mehmetkl/AC-DC-Battery-Charger-Project/Final simulations + model/final plots/rectifier diode current.jpg

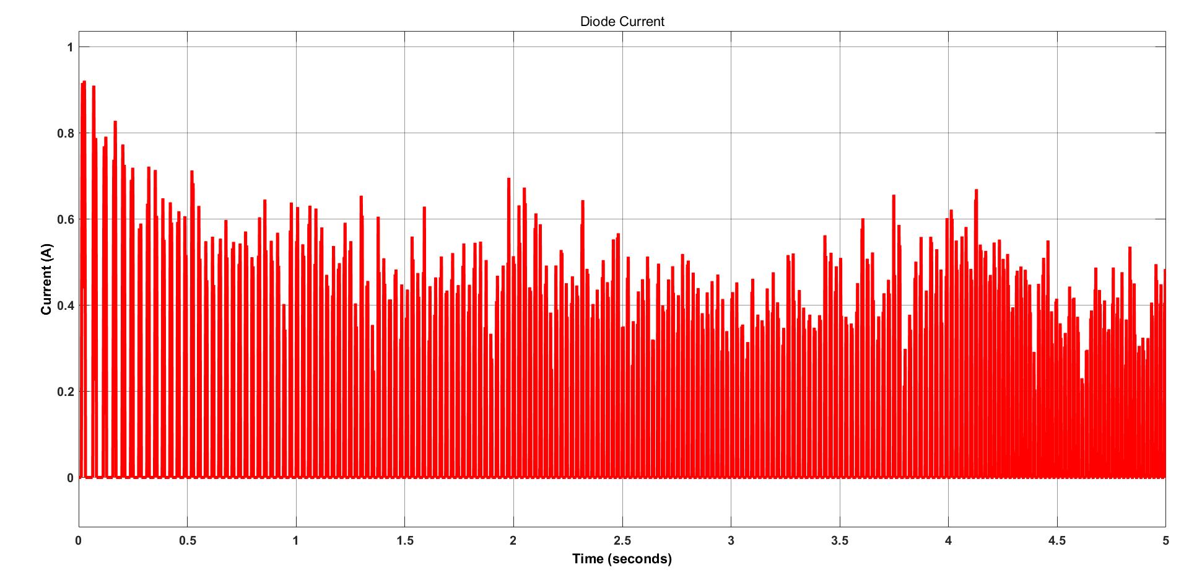
Final simulations + model/final plots/rectifier diode current.jpg
