mehmetkl/AC-DC-Battery-Charger-Project/README.md

# EE463-Term-Project
Aim of this project is development of an AC to DC battery charger. @alibelli and @mustafayildz are my partners.

Report Link;
https://docs.google.com/document/d/1pQeKIka4XDIwBPZ2k292Jc178dQlImezZrbRqhxObMo/edit
