mehmetkl/AC-DC-Battery-Charger-Project/Report/PCB.docx

Appendix

Printed Circuit Board Drawings

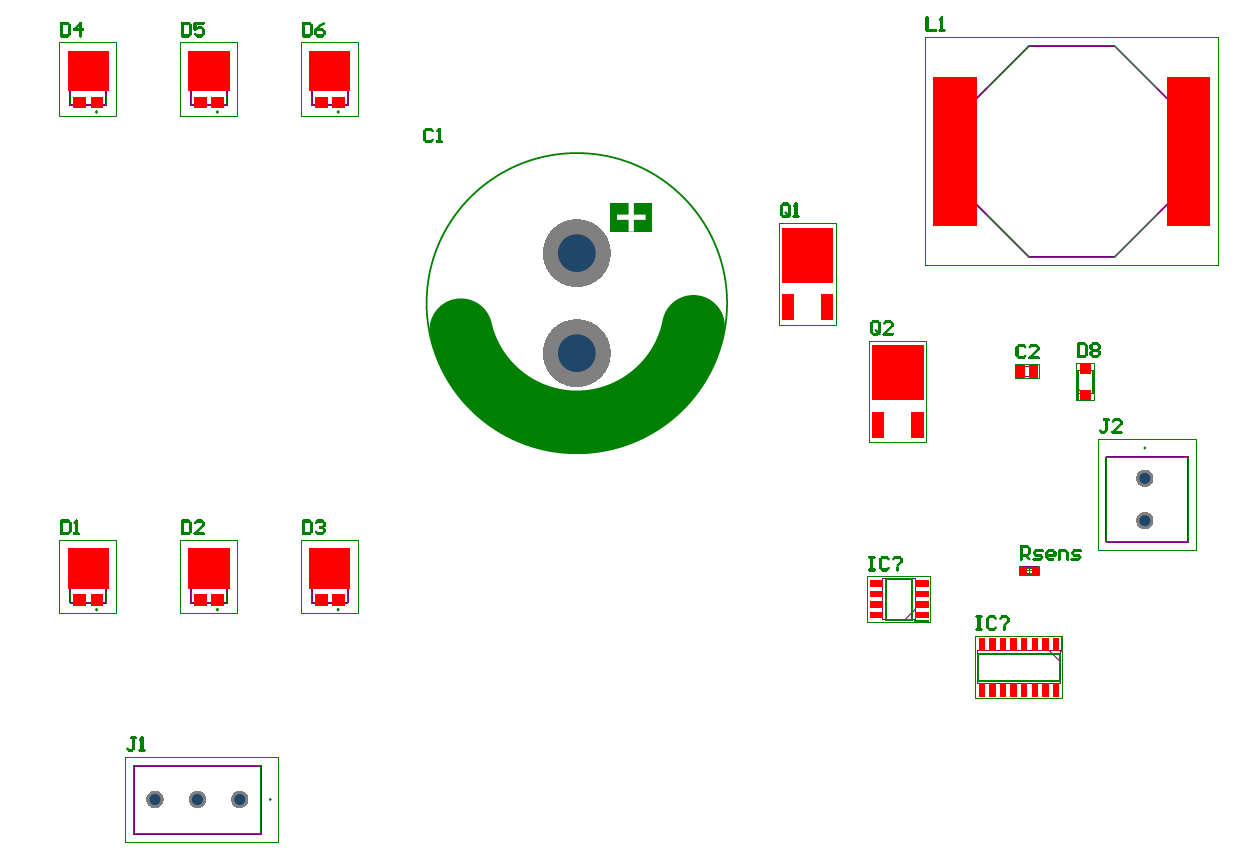
[picture p53: figure]

Figure 1. Approximate distribution of Components on PCB (The PCB limits are not shown for demonstration)

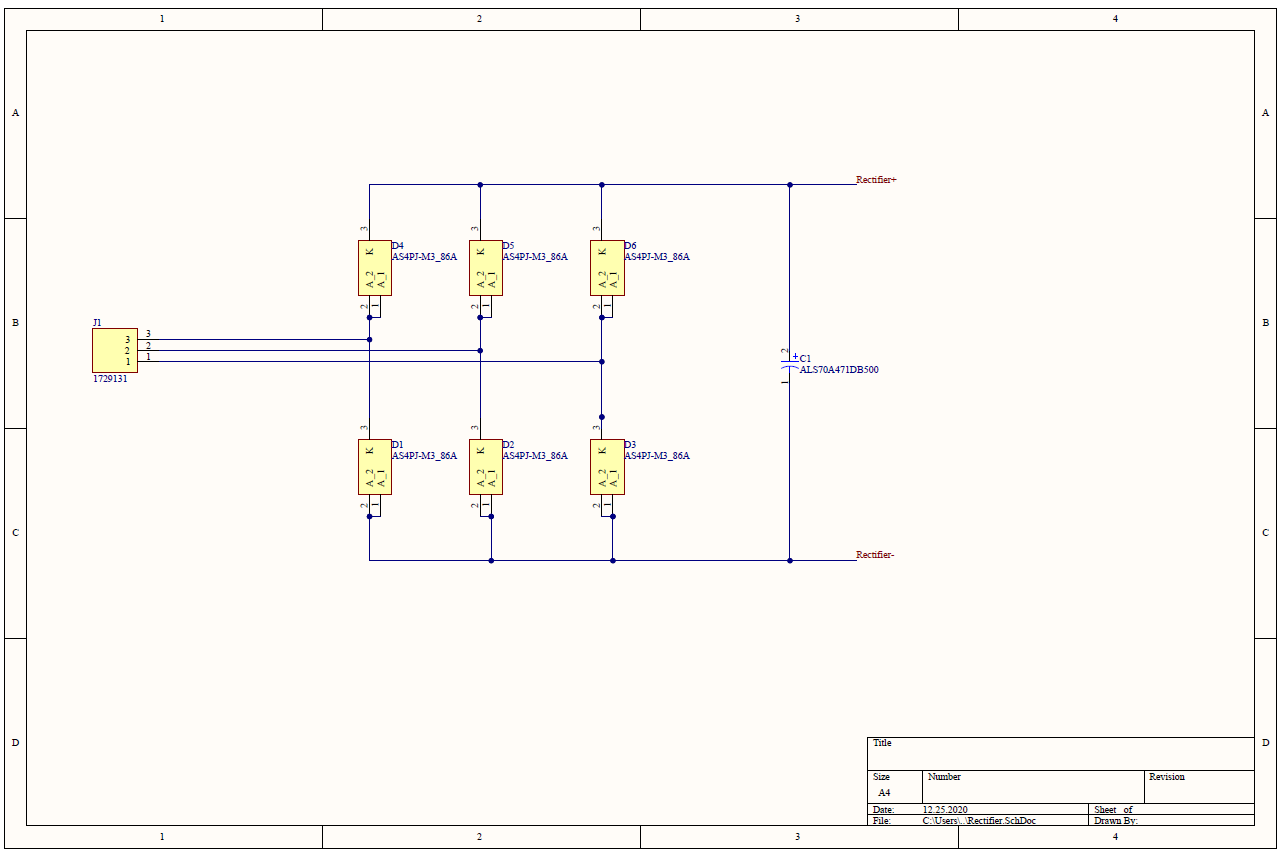
[picture p54: figure]

Figure 2. Completed Schematic of rectifier circuit

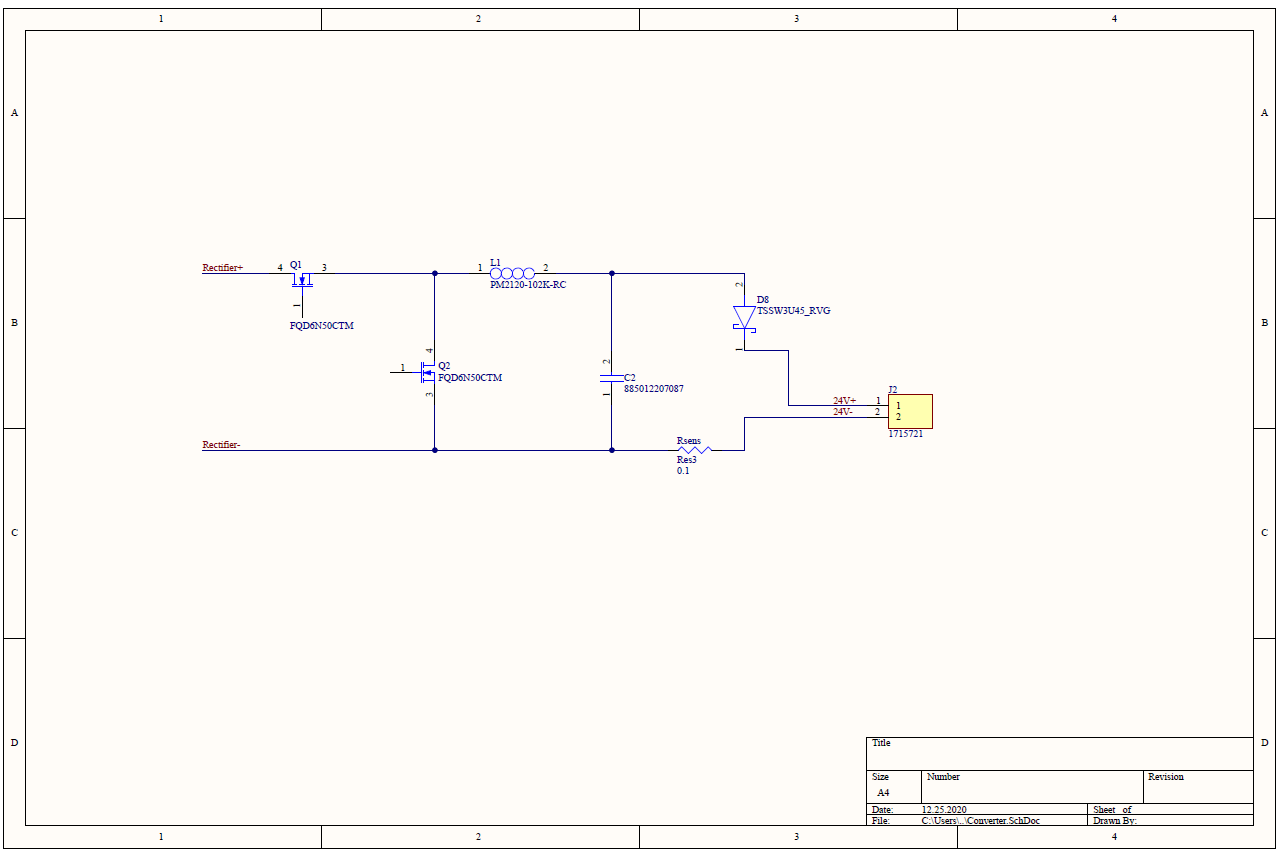
[picture p55: figure]

Figure 3. Schematic of Buck Converter circuit (Current sense is missing)

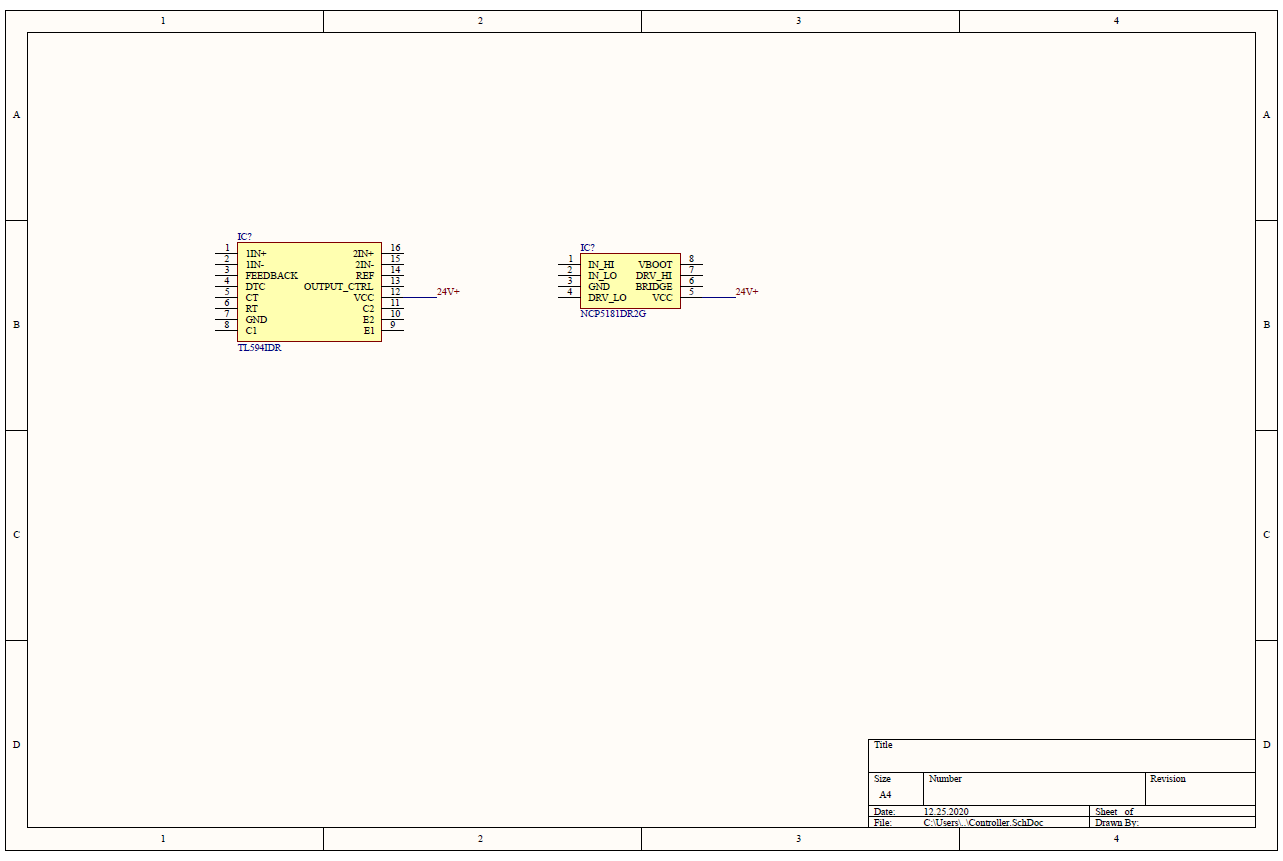
[picture p56: figure]

Figure 4. Schematic of Controller with only Integrated Circuits
