mehmetkl/AC-DC-Battery-Charger-Project/TermProjectPresentation.pptx

## METU Electrical&Electronics Engineering EE463 – Term Project Deadly Viper Assassination Squad Inc.

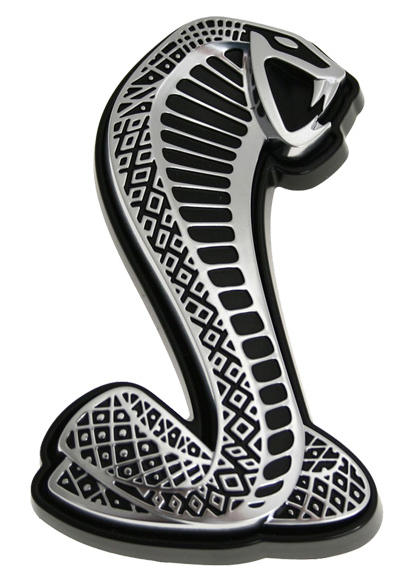
[picture p57: figure]

Mustafa Yıldız
Ali Belli
Mehmet Kılıç

## Problem Definition

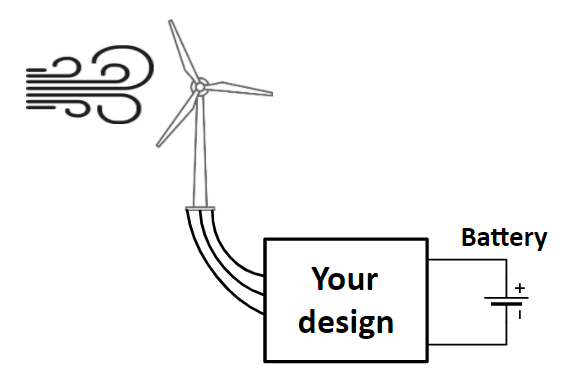
[picture p58: figure]

- Variable amplitude
- Variable frequency
- Regulated output

## Topology Discussion

- Thyristor Rectifier

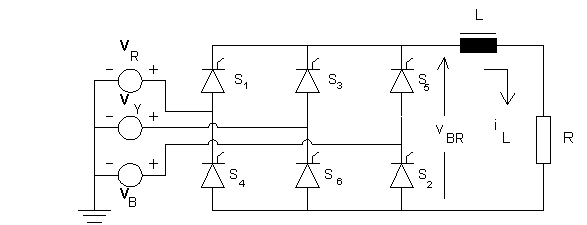
[picture p59: figure]

## Topology Discussion

- Full Wave Diode rectifier and Two Stage Buck Converter

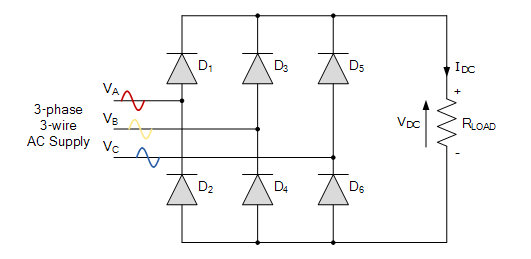
[picture p60: figure]
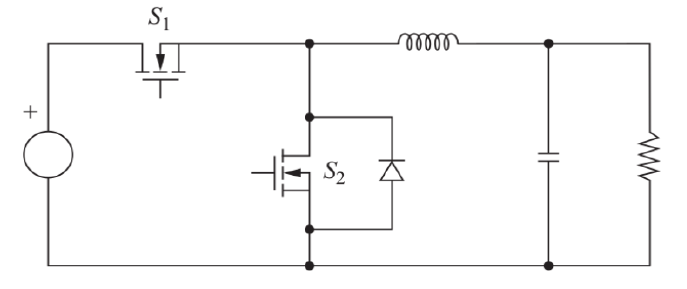
[picture p61: figure]

## Topology Discussion

- Full Wave Diode rectifier and Buck Converter

## Topology Discussion

- Half Wave Diode Rectifier and Full Wave Diode Rectifier

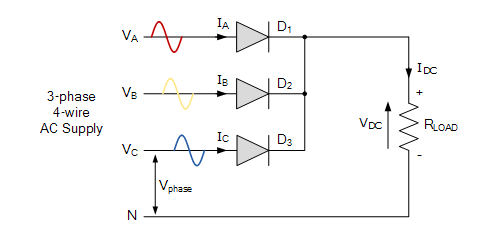
[picture p62: figure]

## General View of the System

## Input and Rectifier Stage

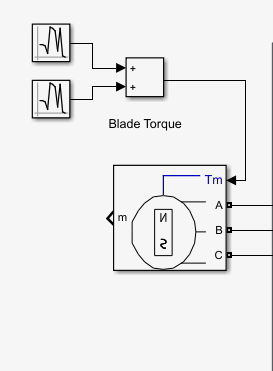
[picture p63: figure]
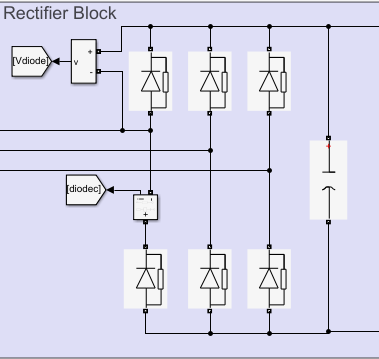
[picture p64: figure]

## Input and Rectifier Stage

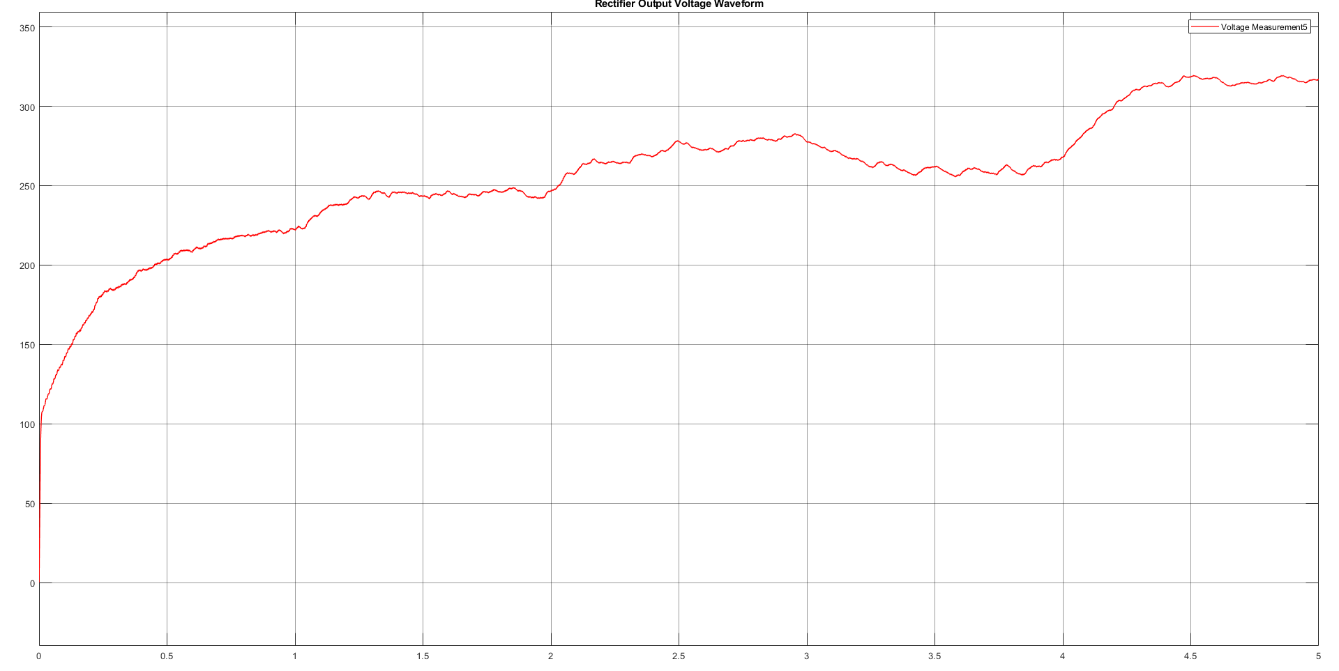
[picture p65: figure]

## Rectifier Stage Output Waveforms

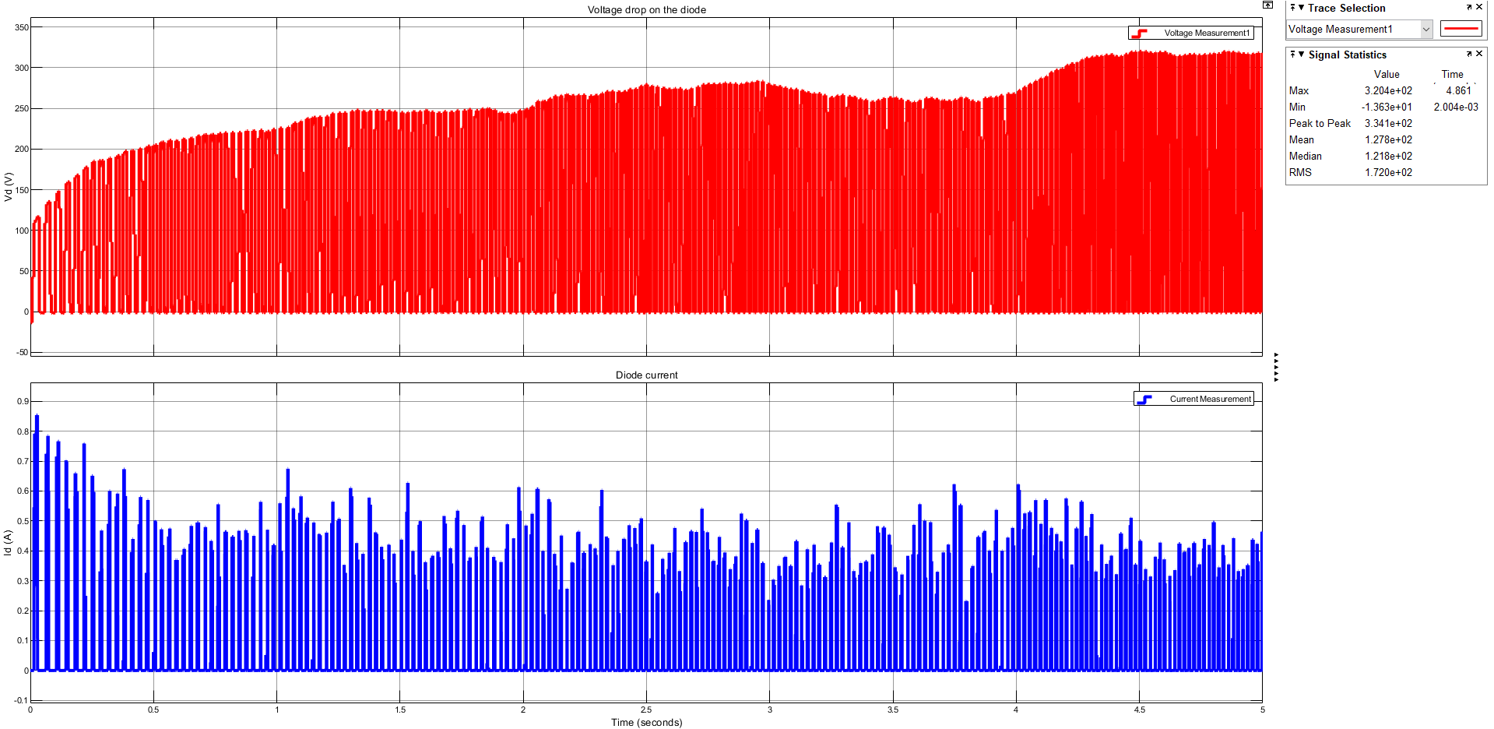
[picture p66: figure]

## Rectifier Stage Component Selection

AS4PJ-M3/86A Diode ALS70A471DB500 Electrolytic Capacitor

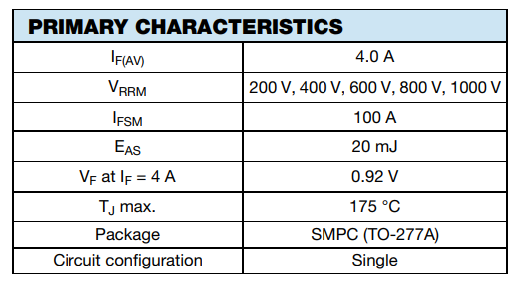
[picture p67: figure]
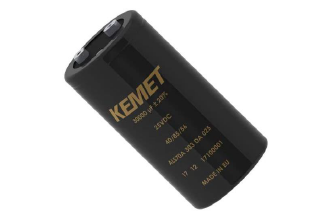
[picture p68: figure]

## Buck Converter and Synchronous Buck Converter


## Synchronous Buck Converter Stage

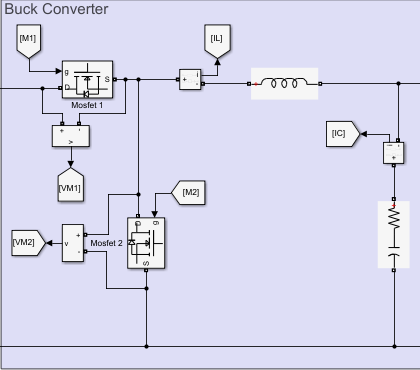
[picture p69: figure]

## Buck Converter Simulation Results

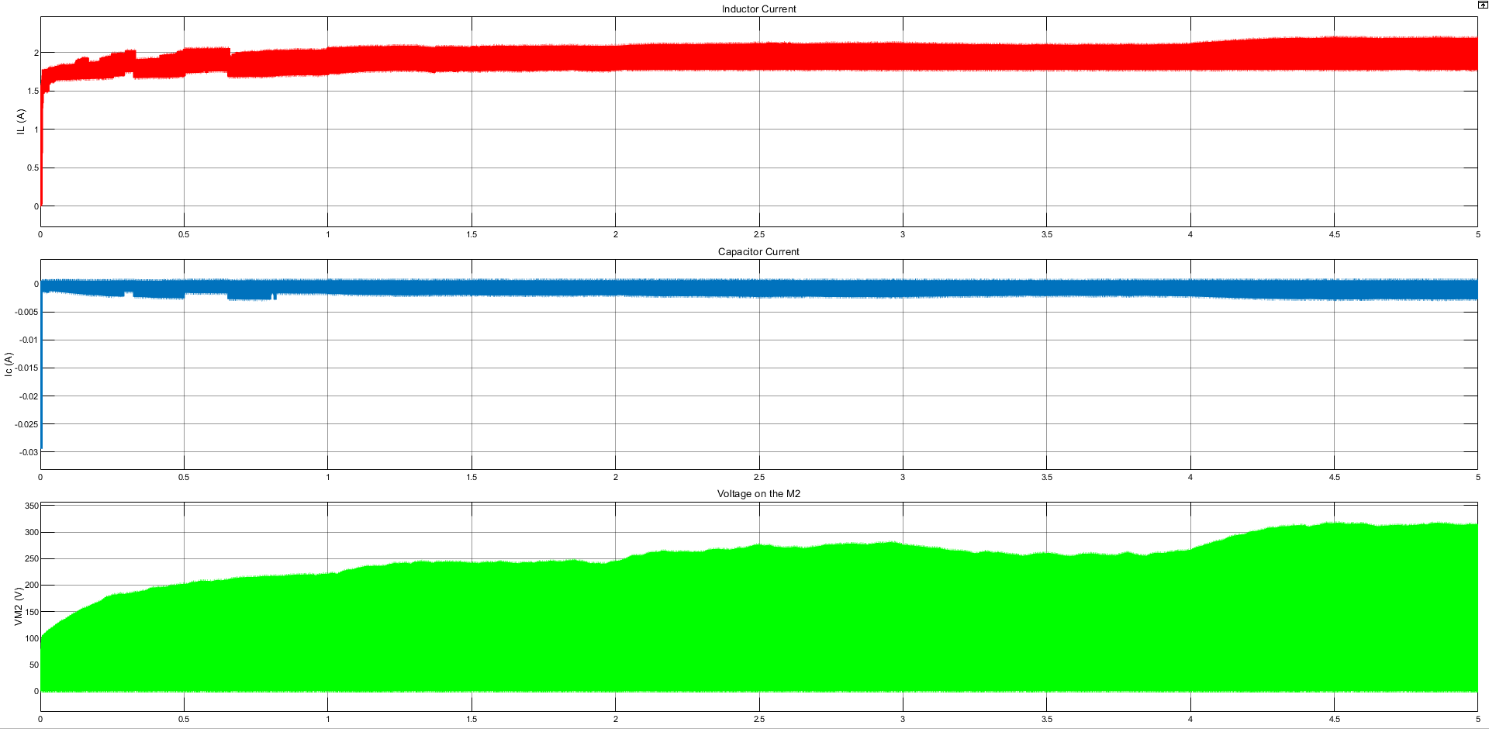
[picture p70: figure]

## Buck Converter Simulation Results

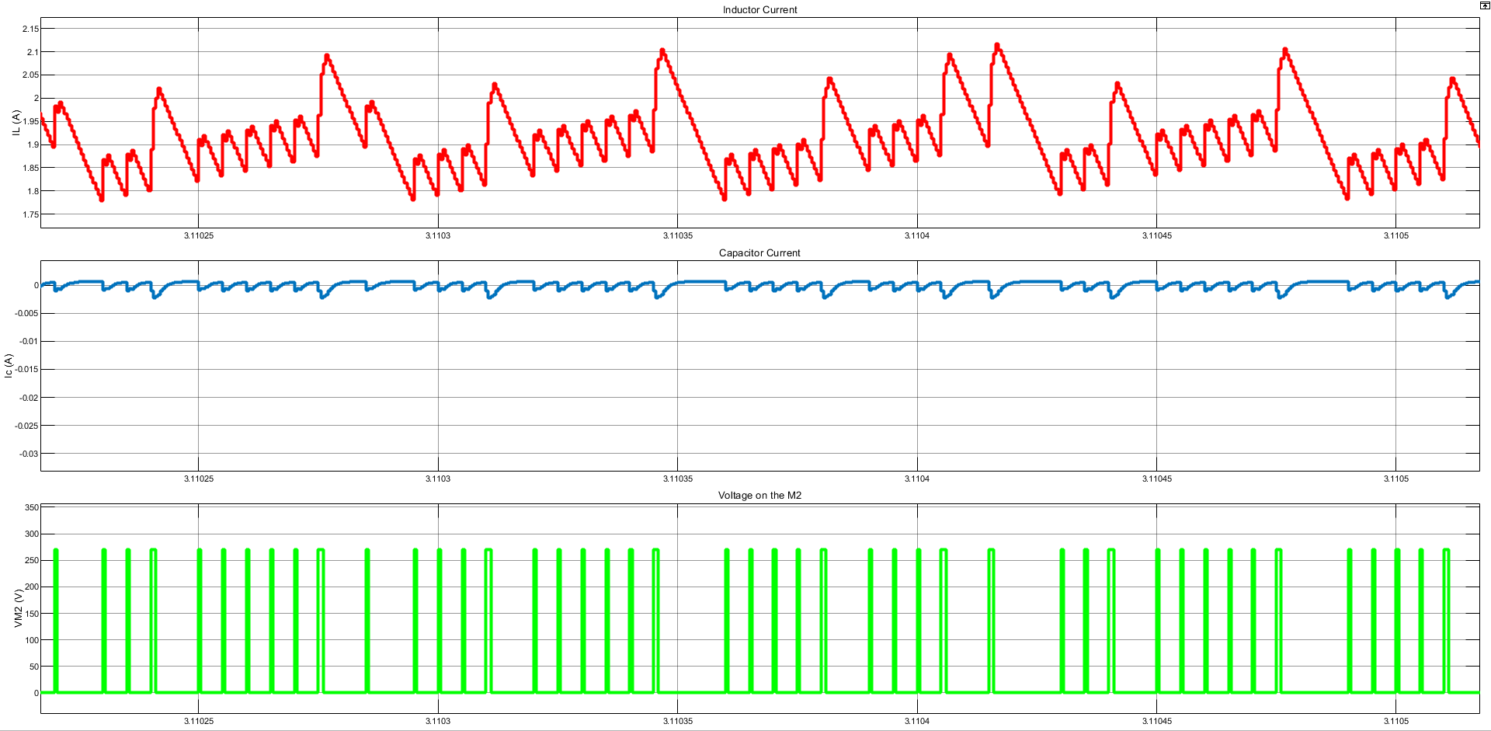
[picture p71: figure]

## Buck Converter Simulation Results

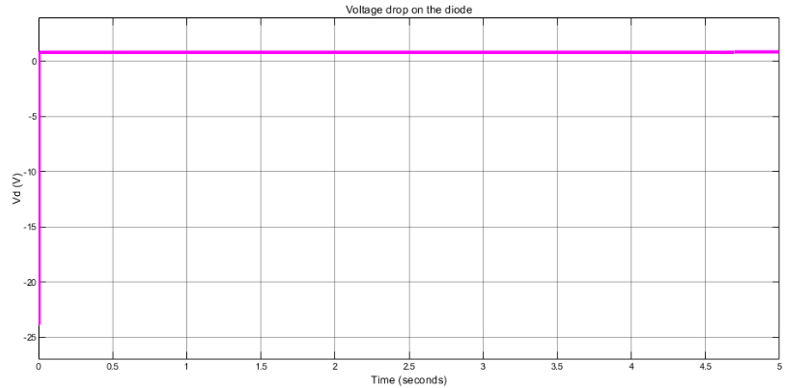
[picture p72: figure]

TSSW3U45 45V/3A

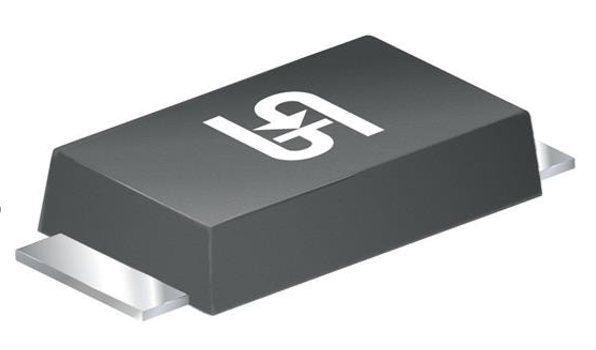
[picture p73: figure]

## Buck Converter Simulation Results

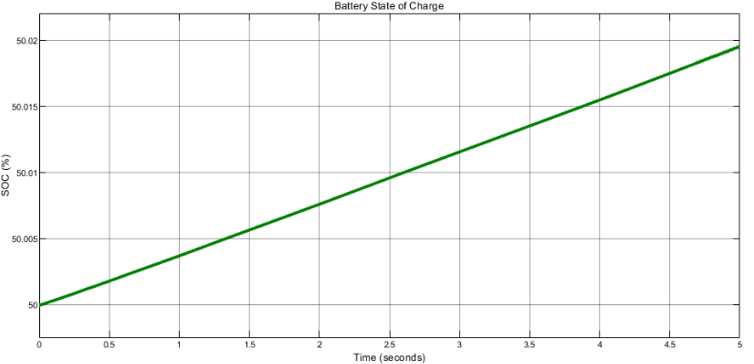
[picture p74: figure]

## Buck Converter Component Selection

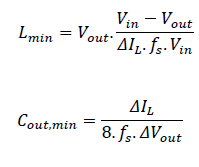
[picture p75: figure]

## Buck Converter Component Selection

PM2120-102K-RC 1mH Inductance 885012207087 1500nF Capacitor FQD6N50C-D 500V/4.5A

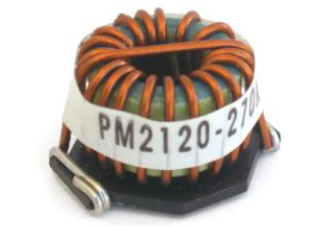
[picture p76: figure]
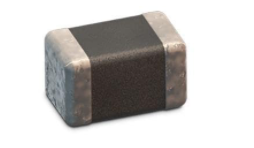
[picture p77: figure]
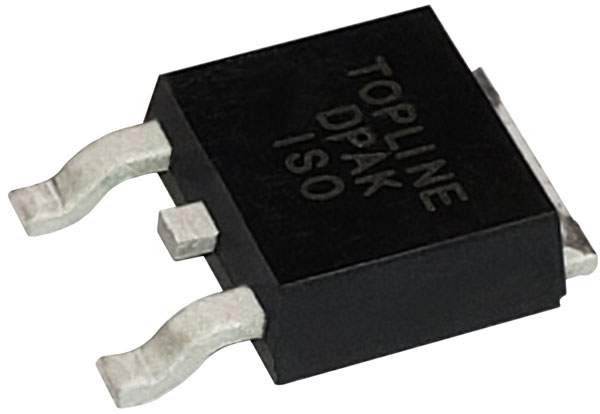
[picture p78: figure]
DPAK, D2PAK package JEDEC device TopLine Dummy Component Power Transistor DPAK, DPAK-E13A, DPAKE13A, DPAK E13A, DPAK-E7A, DPAKE7A, DPAK E7A, DPAK3, DPAK-2, DPAK 2, DPAK2, DPAK-3, DPAK 3, DPAK3, D-PAK, DPACK, D-PACK, DPAK (

## Controller Stage

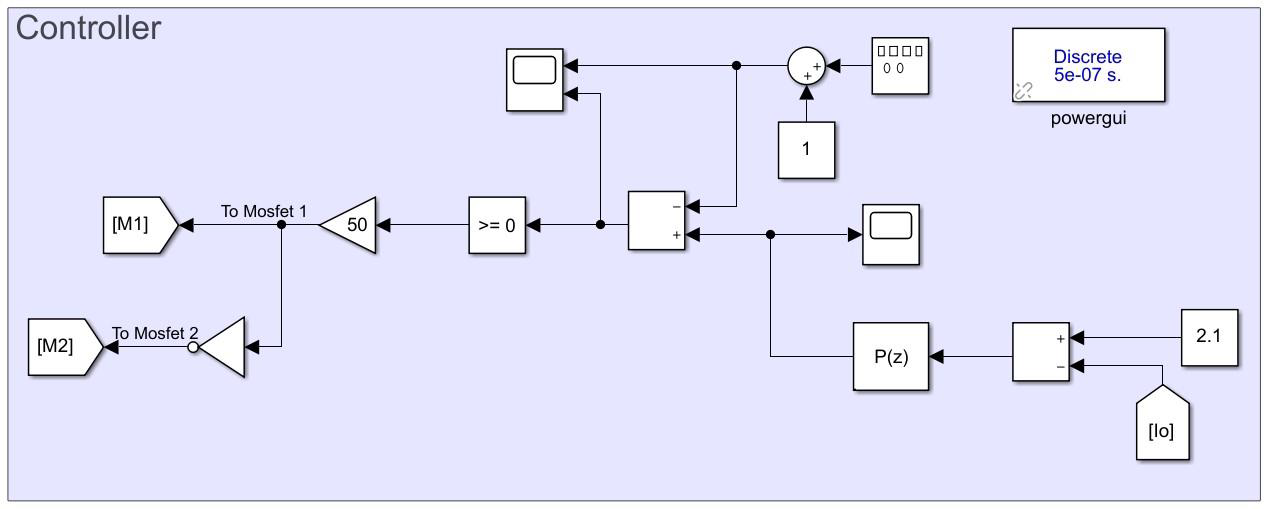
[picture p79: figure]

## Controller Stage Waveforms

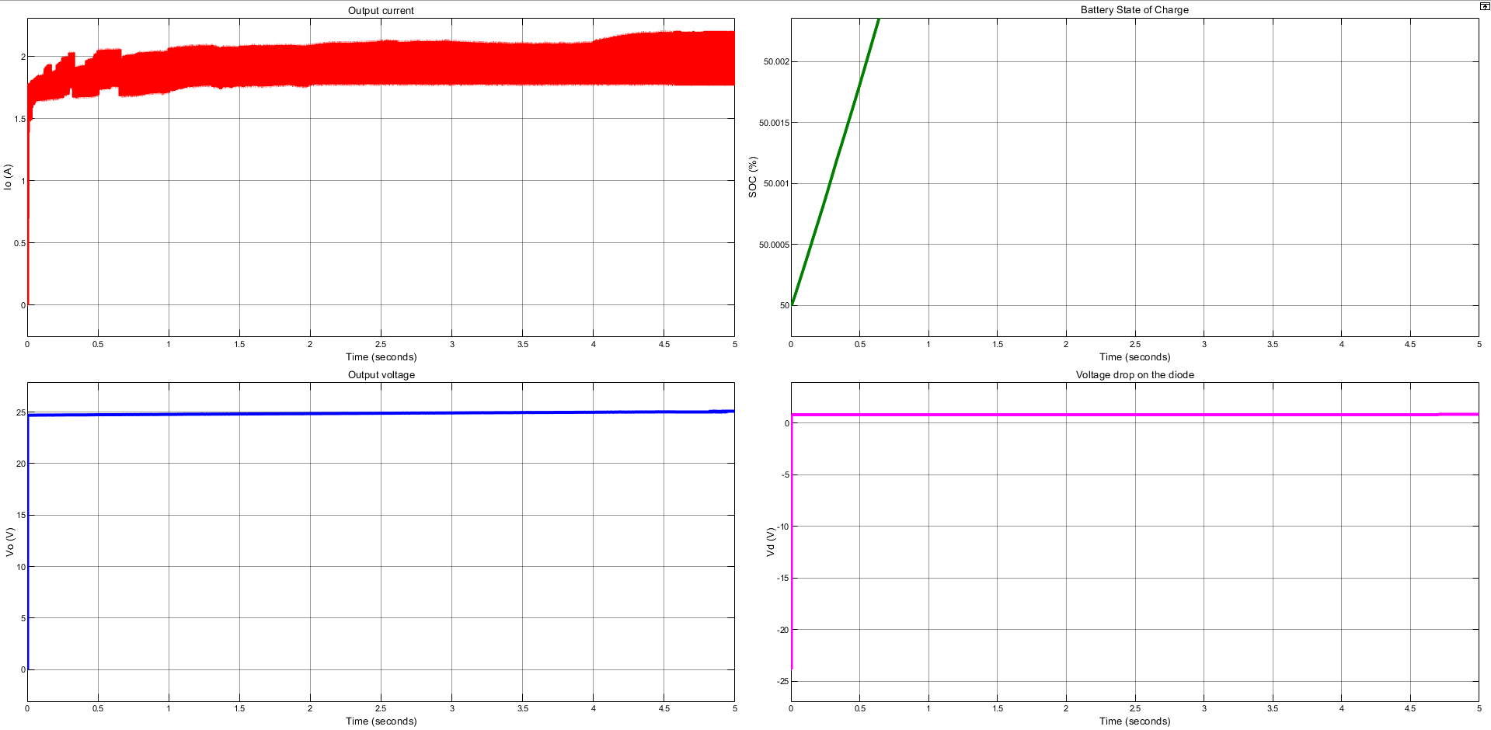
[picture p80: figure]

## Controller Stage Output Current Waveform

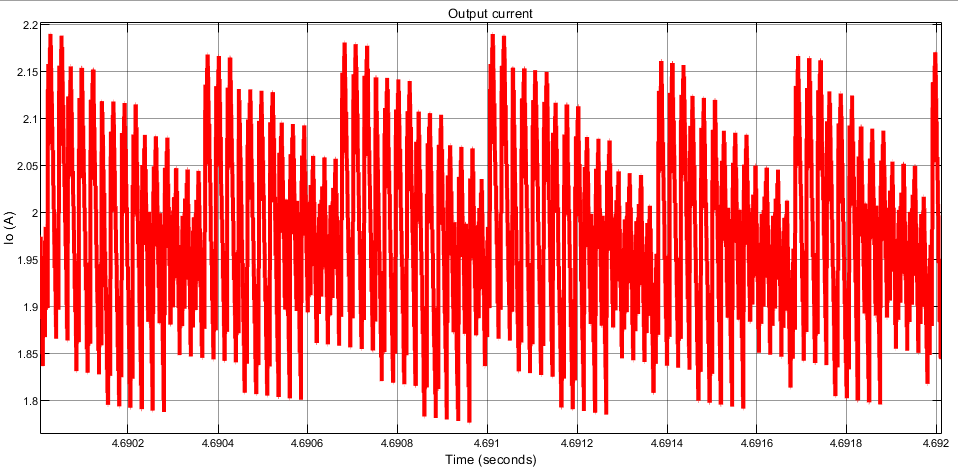
[picture p81: figure]

## Controller Stage Component Selection

PWM Generator TL594IDR Dual Output Mosfet Driver NCP5181DR2G, up to 600V

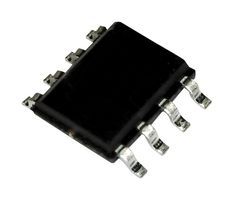
[picture p82: figure]
NCP5181DR2G - ON SEMICONDUCTOR - MOSFET/IGBT Driver, Half Bridge, 10V to 20V Supply
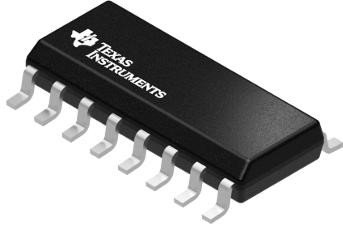
[picture p83: figure]
TL594IDR by Texas Instruments | Current Mode PWM Controllers | Arrow.com

## PCB Schematics

Rectifier Stage

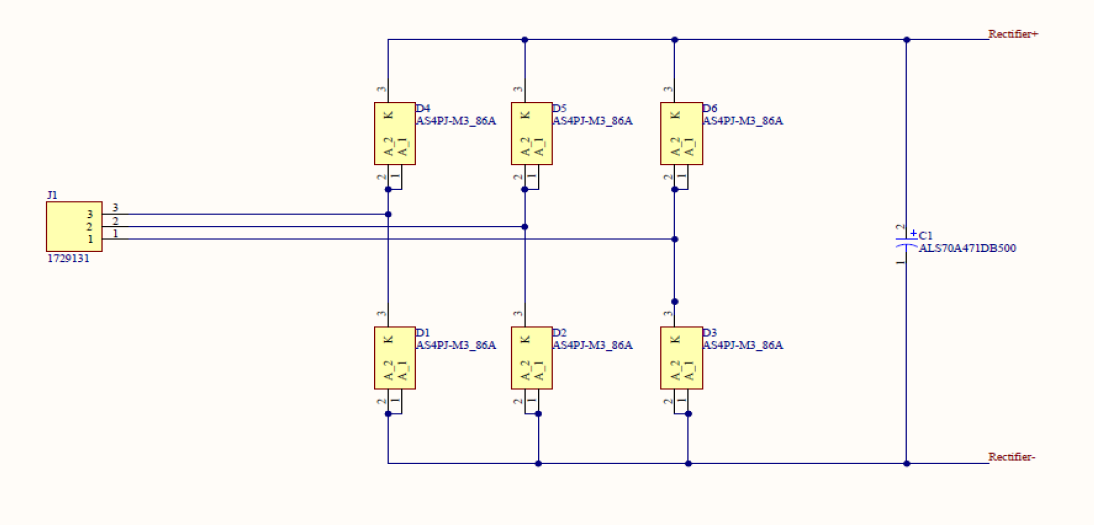
[picture p84: figure]

## PCB Schematics

Converter Stage

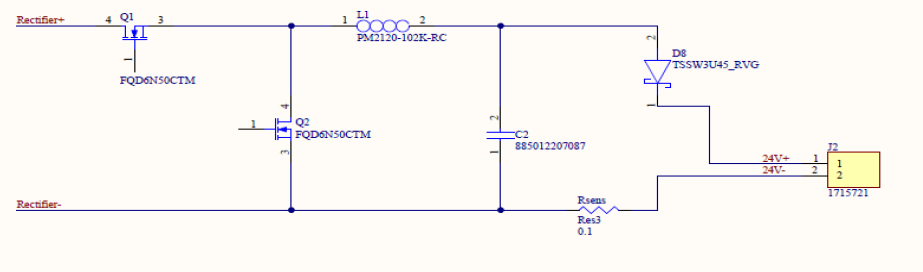
[picture p85: figure]

## PCB Schematics

PCB Layout without Wirings and Mechanical Limits of PCB

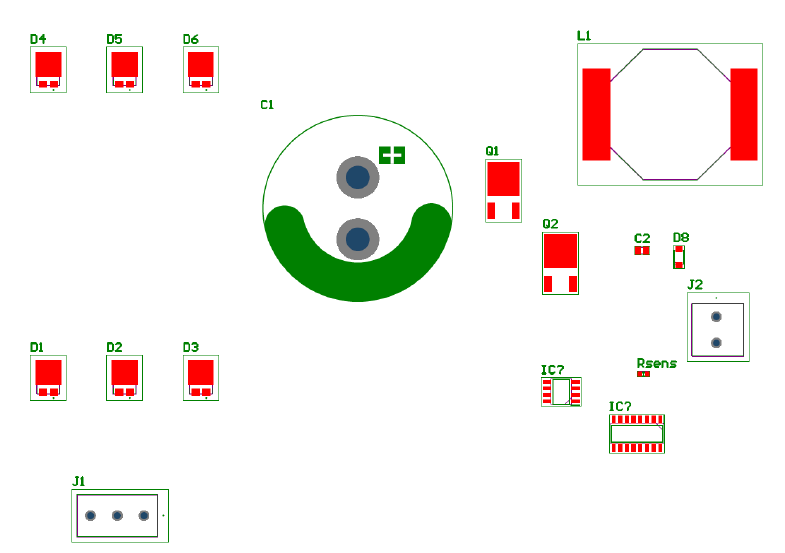
[picture p86: figure]

## Slide 27

Thanks for listening...
