mehmetkl/AC-DC-Battery-Charger-Project/Buck_converter/Buck converter parameters.docx

L_(min) =V_(out) .(V_(in) -V_(out))/(ΔI_L .f_s .V_(in))

L_(min) =(24x(300-24))/(0.4x200000x300)=2.74x10^(-4) H

C_(out,min) =ΔI_L /(8.f_s .ΔV_(out) )

C_(out) =0.4/(8x200000x0.5)=0.5x10^(-6) F
