mehmetkl/AC-DC-Battery-Charger-Project/Final simulations + model/controller block_new.jpg

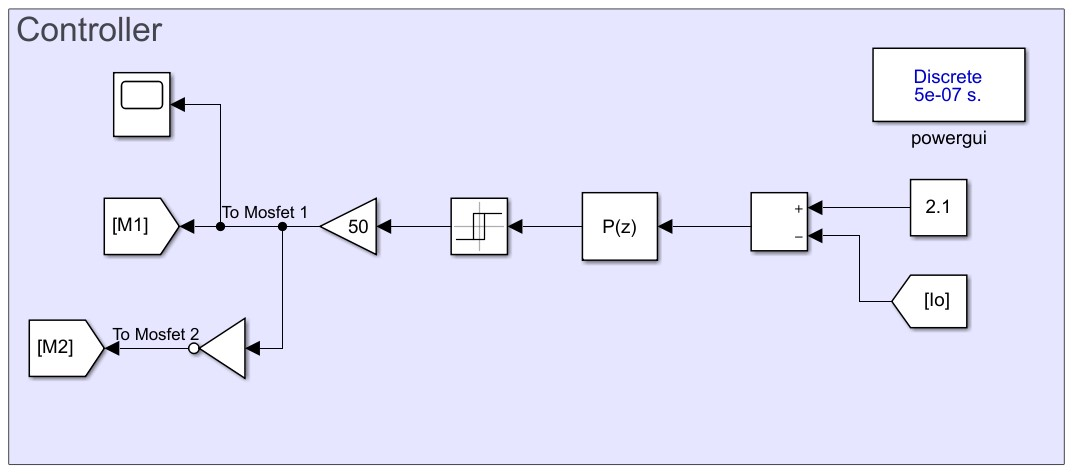
Final simulations + model/controller block_new.jpg
