mehmetkl/AC-DC-Battery-Charger-Project/Final simulations + model/final plots/inductor current.jpg

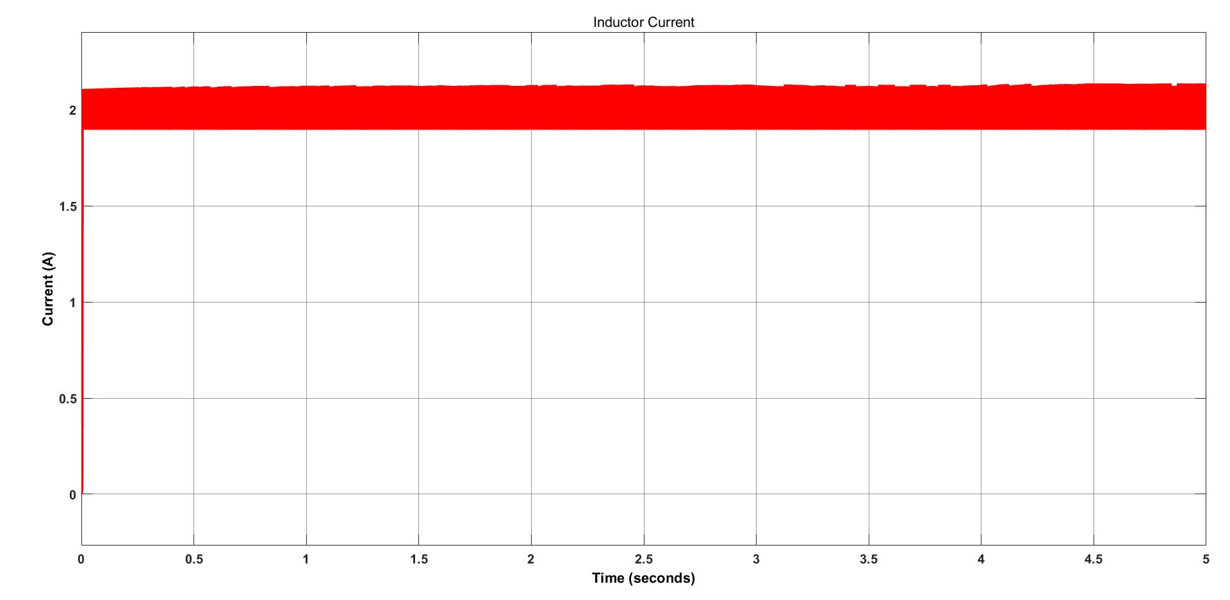
Final simulations + model/final plots/inductor current.jpg
