mehmetkl/AC-DC-Battery-Charger-Project/Final simulations + model/final plots/MOSFET 2 Voltage.jpg

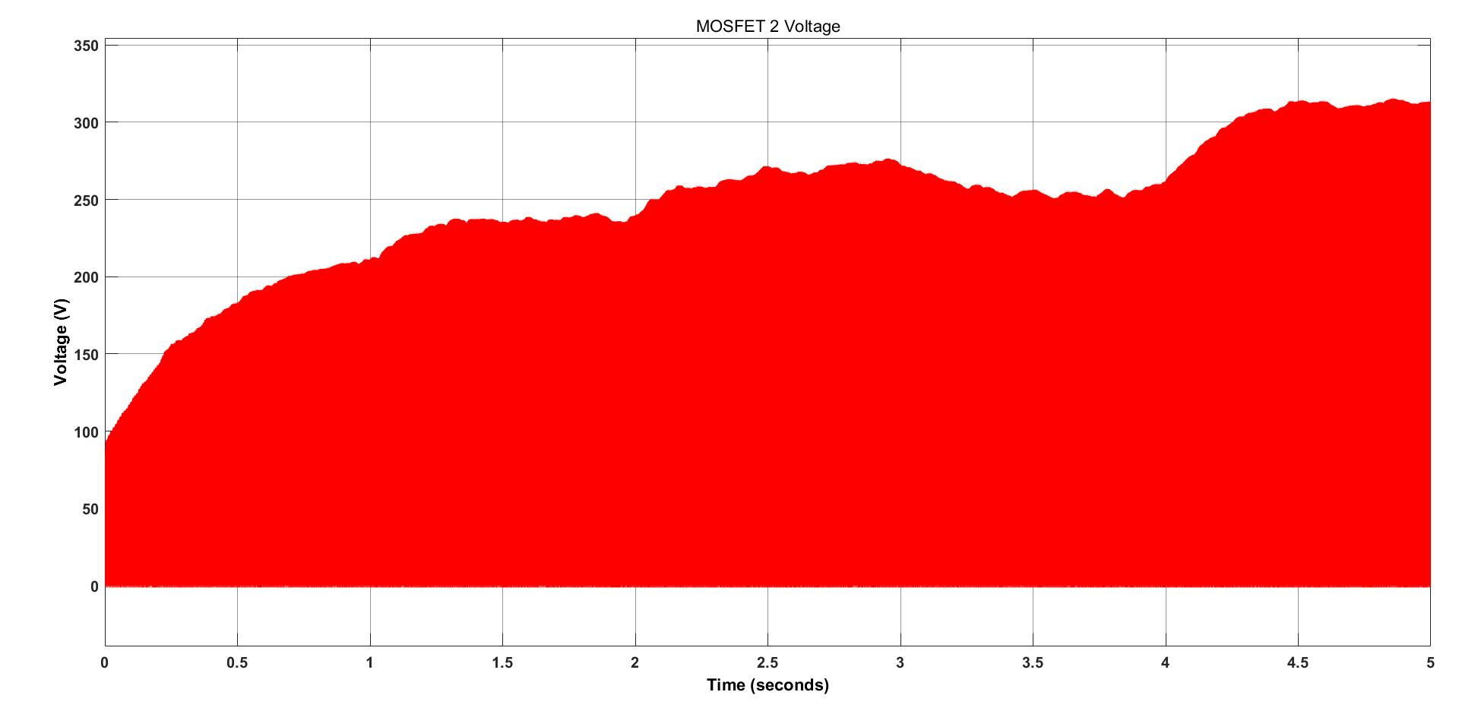
Final simulations + model/final plots/MOSFET 2 Voltage.jpg
