mehmetkl/AC-DC-Battery-Charger-Project/Final simulations + model/final plots/out cap current.jpg

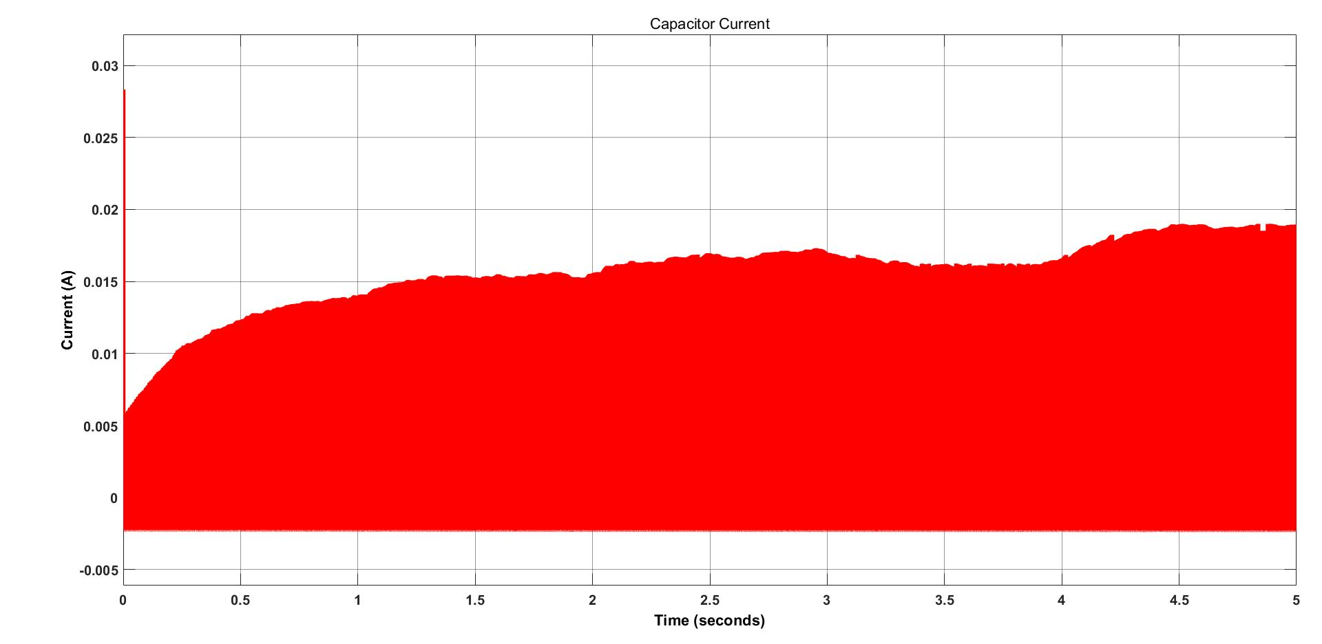
Final simulations + model/final plots/out cap current.jpg
