mehmetkl/AC-DC-Battery-Charger-Project/Final simulations + model/final plots/output voltage.jpg

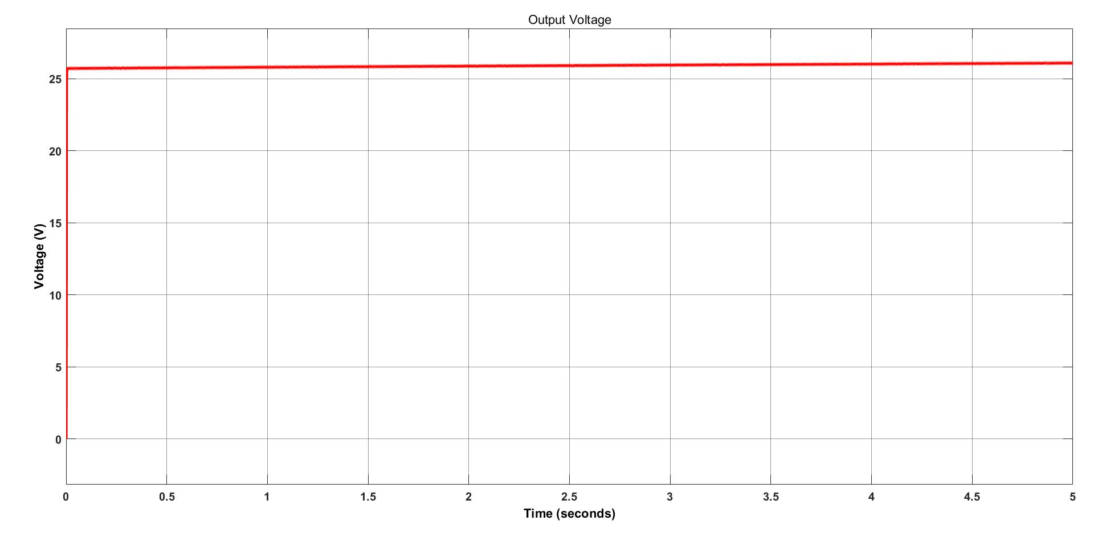
Final simulations + model/final plots/output voltage.jpg
