mehmetkl/AC-DC-Battery-Charger-Project/Final simulations + model/final plots/rectifier capacitor voltage.jpg

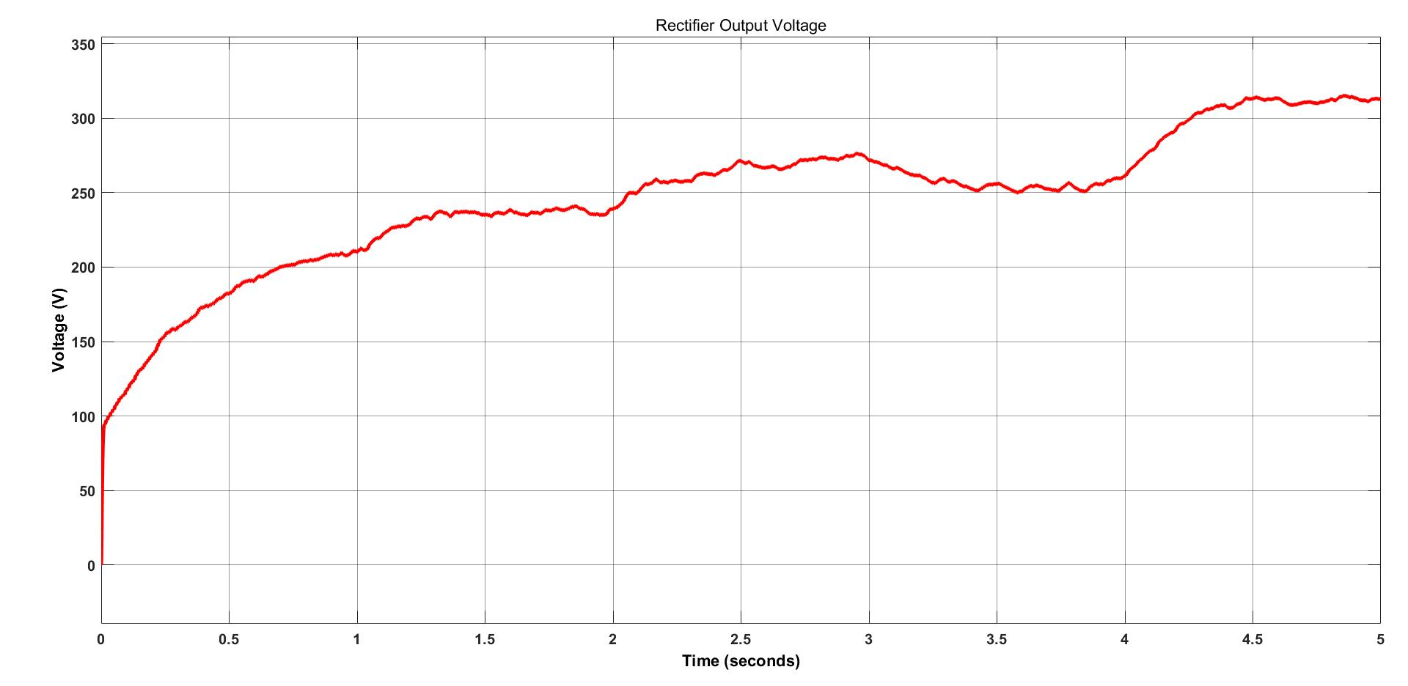
Final simulations + model/final plots/rectifier capacitor voltage.jpg
