mehmetkl/AC-DC-Battery-Charger-Project/Final simulations + model/final plots/SOC battery.jpg

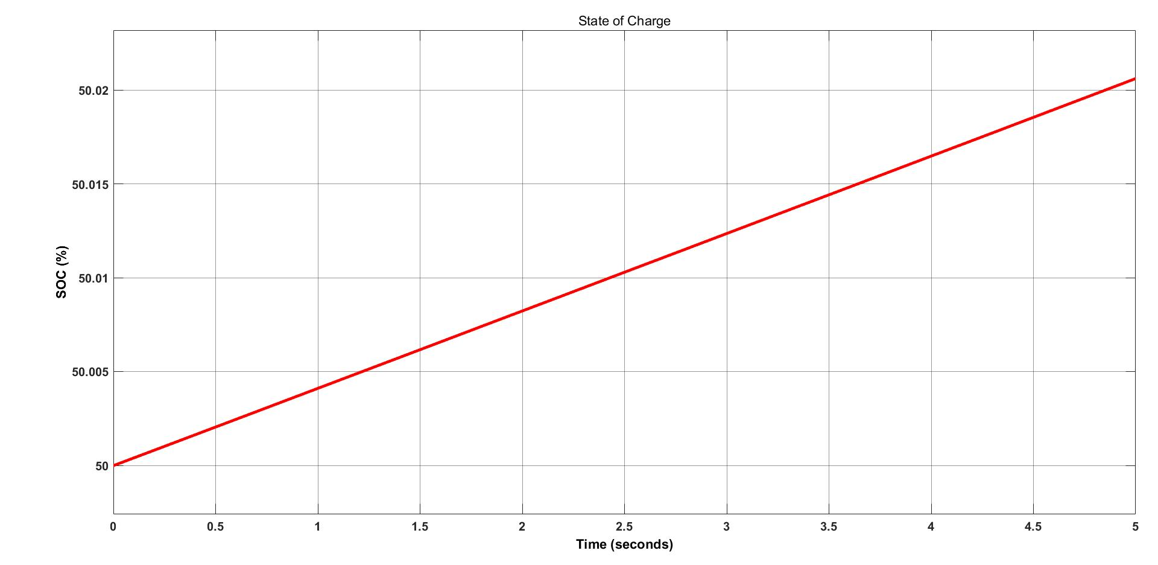
Final simulations + model/final plots/SOC battery.jpg
