mehmetkl/AC-DC-Battery-Charger-Project/Final simulations + model/rectifier block.jpg

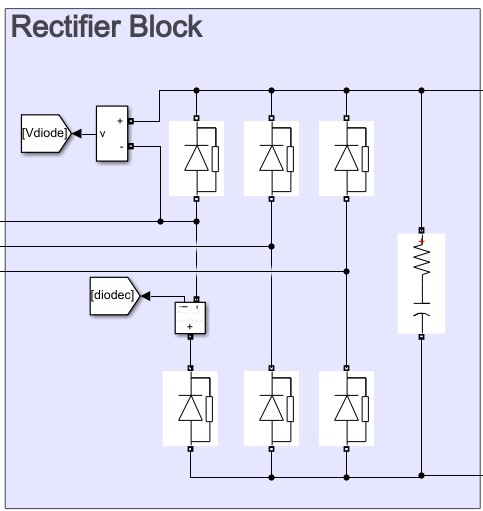
Final simulations + model/rectifier block.jpg
