mehmetkl/AC-DC-Battery-Charger-Project/Final simulations + model/Vm1 mosfet Voltage.png

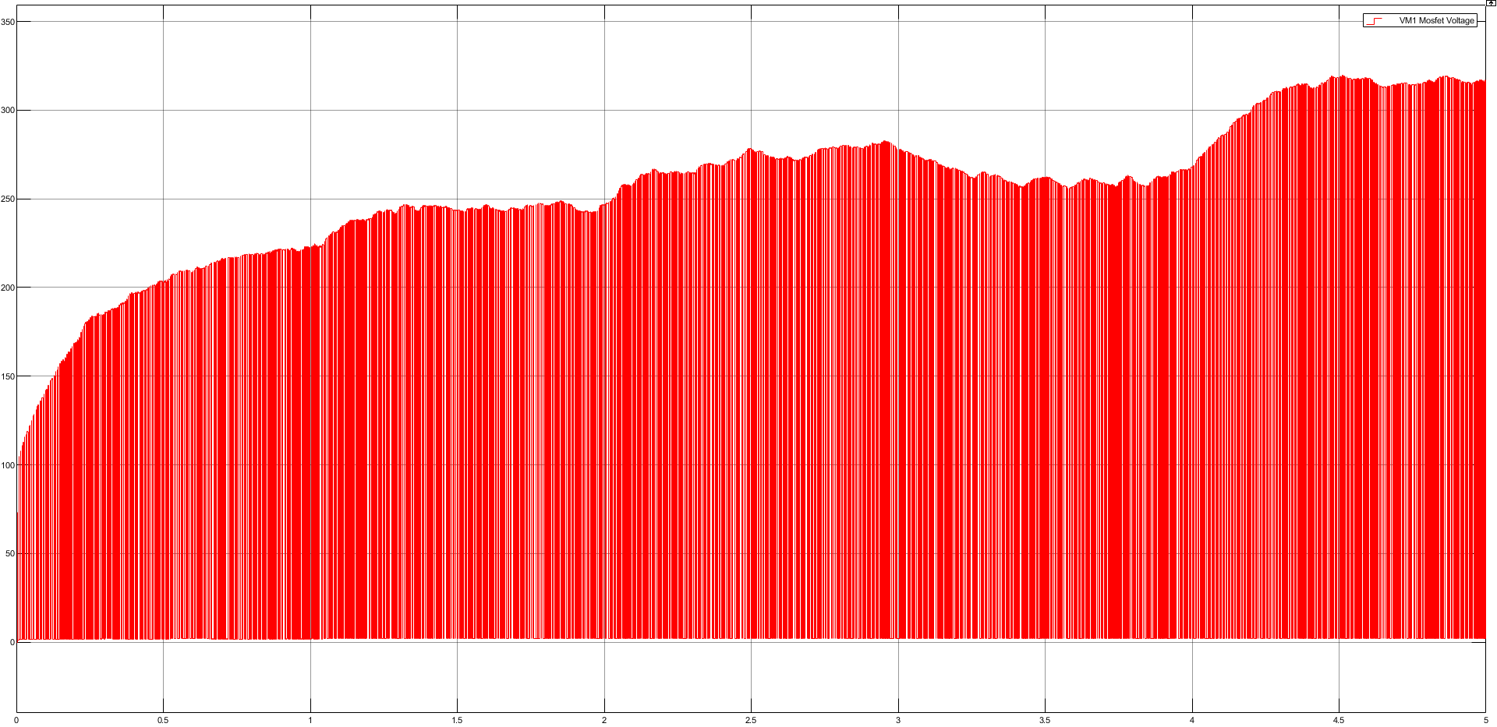
Final simulations + model/Vm1 mosfet Voltage.png
