mehmetkl/AC-DC-Battery-Charger-Project/Output Current Waveform.png

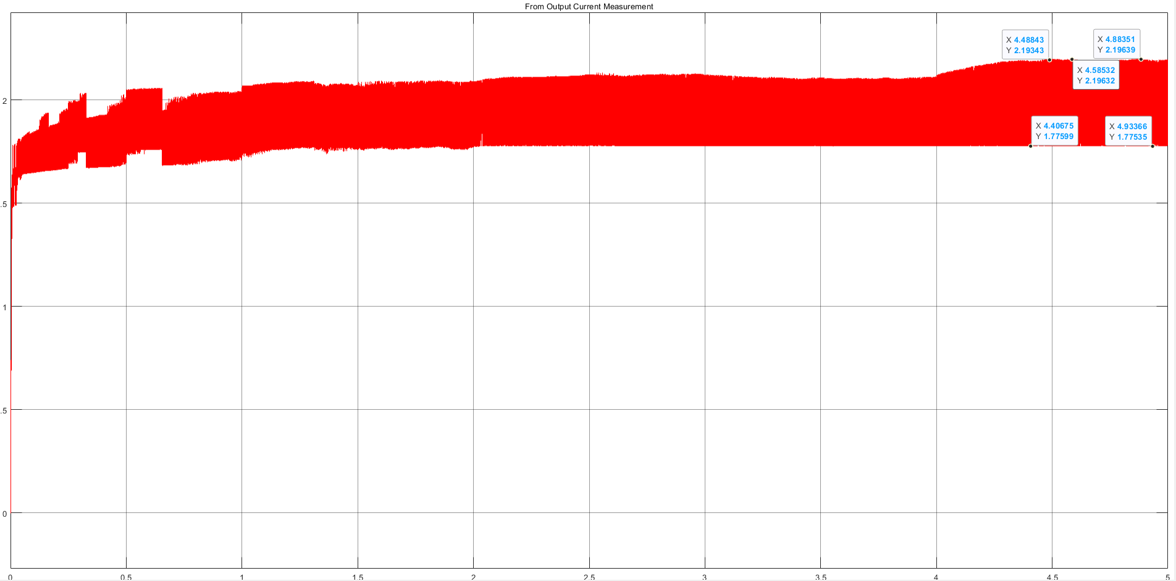
Output Current Waveform.png
