mehmetkl/AC-DC-Battery-Charger-Project/rectifier stage/Current_940.png

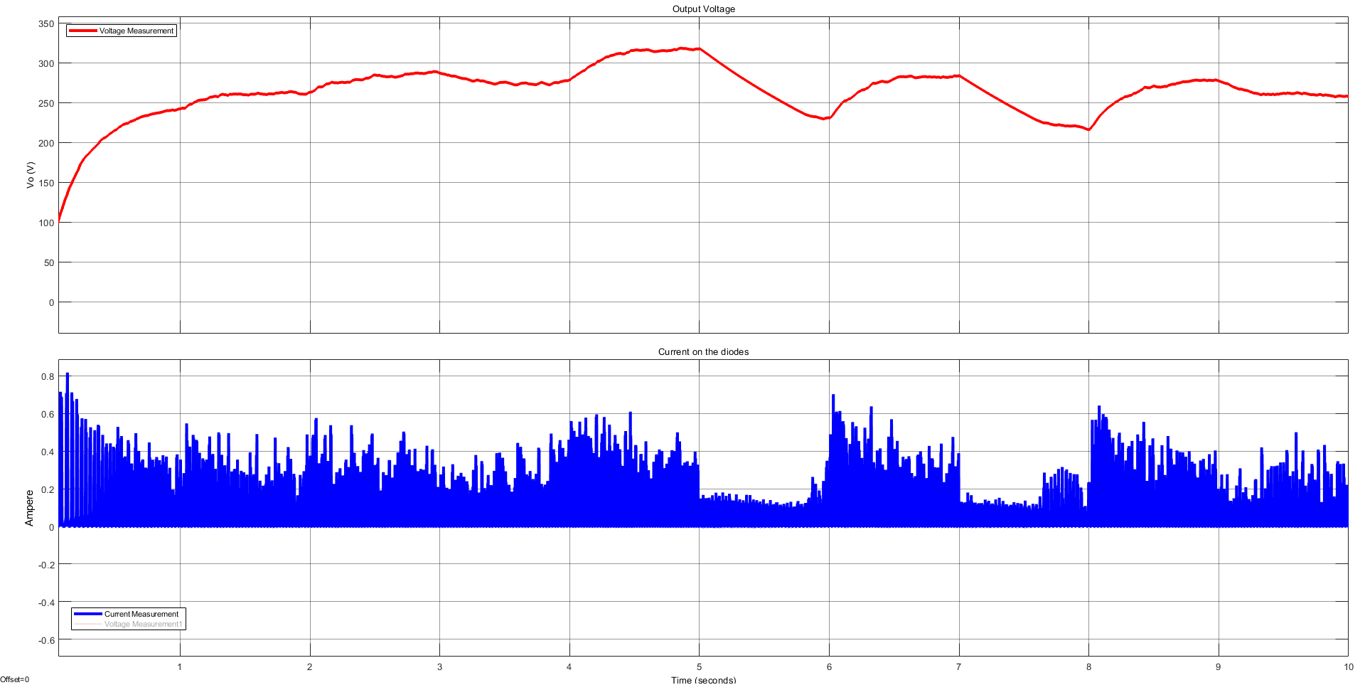
rectifier stage/Current_940.png
