mehmetkl/AC-DC-Battery-Charger-Project/rectifier stage/diode voltage.png

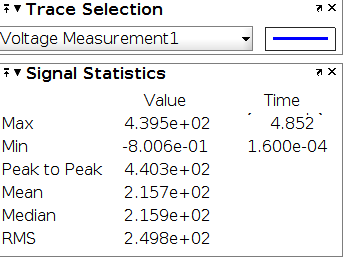
rectifier stage/diode voltage.png
