mehmetkl/AC-DC-Battery-Charger-Project/rectifier stage/output voltage.png

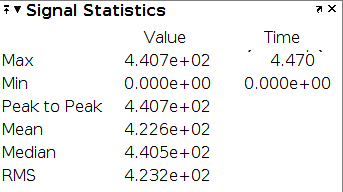
rectifier stage/output voltage.png
