mehmetkl/AC-DC-Battery-Charger-Project/rectifier stage/rectifier output.png

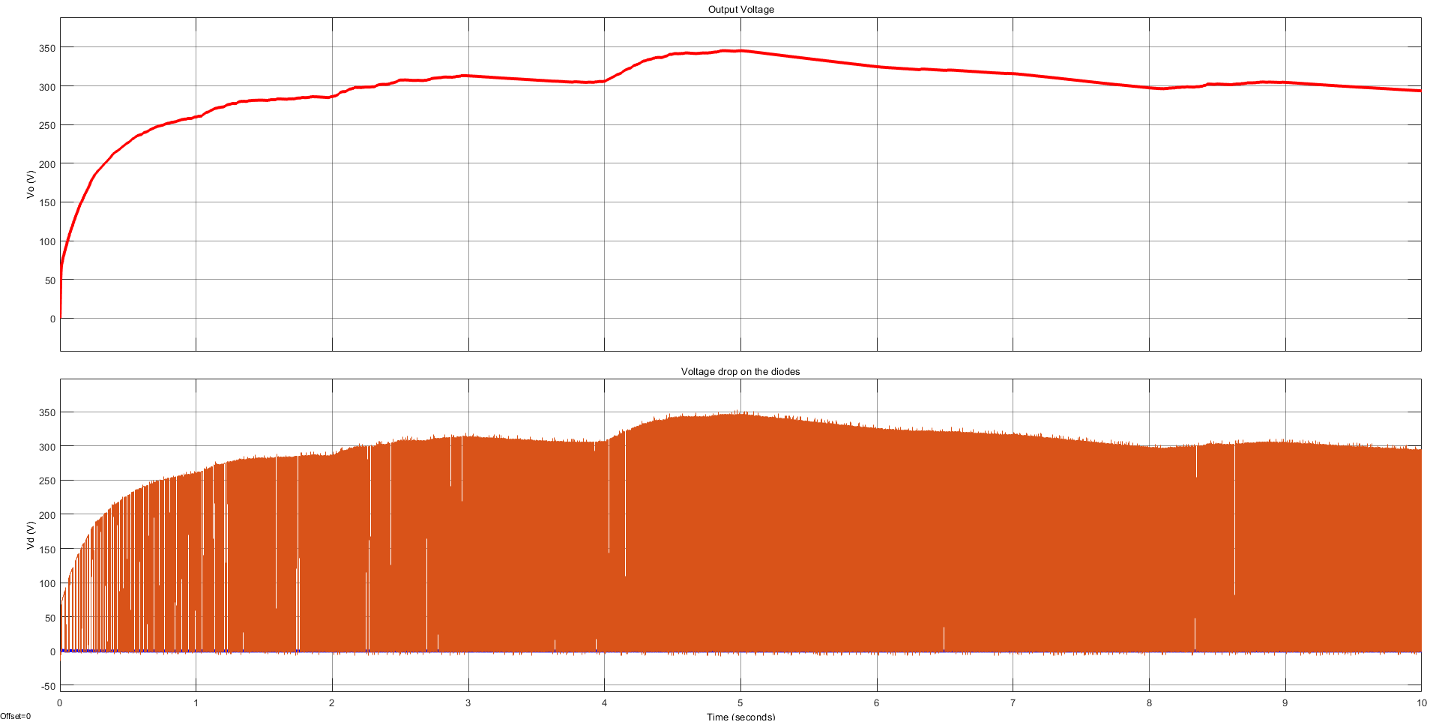
rectifier stage/rectifier output.png
