mehmetkl/AC-DC-Battery-Charger-Project/rectifier stage/rectifier output_940micro.png

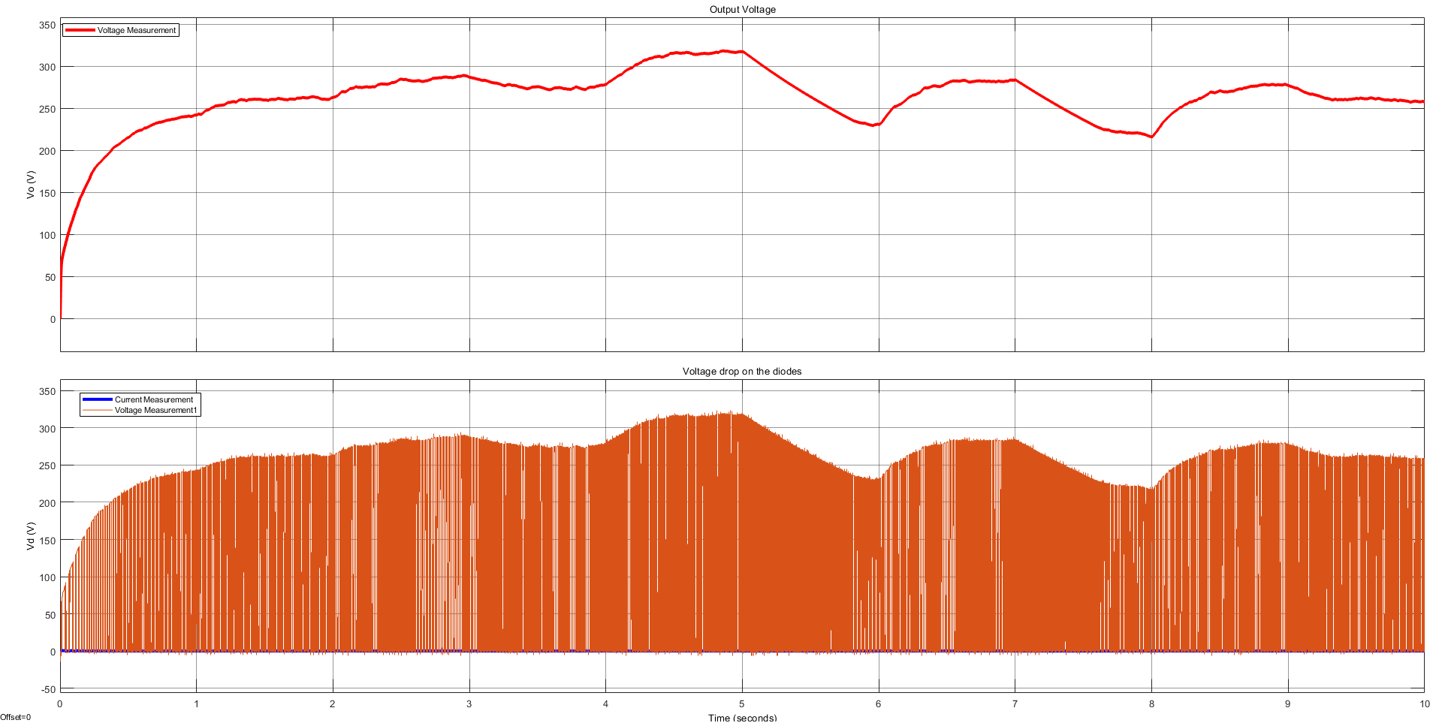
rectifier stage/rectifier output_940micro.png
