mehmetkl/AC-DC-Battery-Charger-Project/rectifier stage/rectifier_plots.jpg

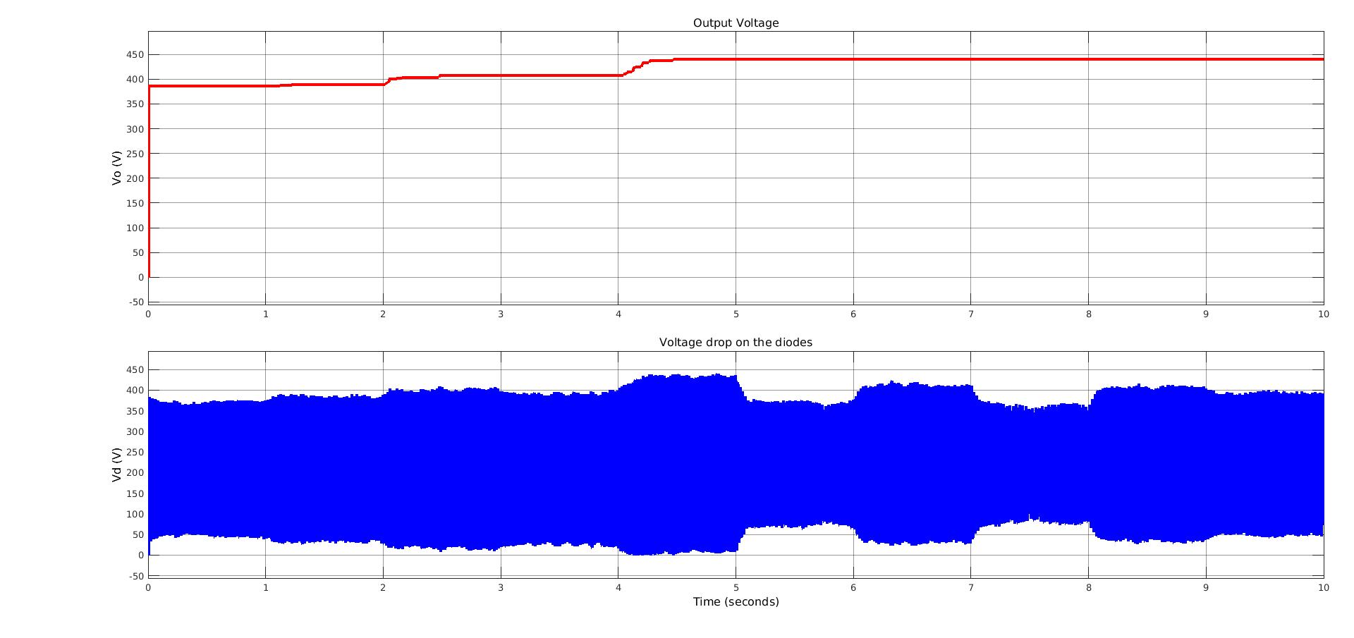
rectifier stage/rectifier_plots.jpg
