mehmetkl/AC-DC-Battery-Charger-Project/Bill of Materials Arrangable.xlsx

Manufacturer Part Number | Digi-Key Part Number | Quantity | Unit Price | Extended Price | Net Price
AS4PJ-M3/86A | AS4PJ-M3/86AGICT-ND | 1000 | 0.36668 | $366.68 | $366.68
PM2120-102K-RC | M8801-ND | 1000 | 1.575 | $1575.00 | $1575.00
FQD6N50CTM | FQD6N50CTMCT-ND | 2000 | 0.41688 | $833.76 | $833.76
450MXH270MEFCSN35X25 | 1189-1995-ND | 2000 | 3.37633 | $6752.66 | $6752.66
RCA06031K00JNEA | 541-2213-1-ND | 2000 | 0.011 | $22.00 | $22.00
RN732ATTD2501B25 | 2019-RN732ATTD2501B25TR-ND | 5000 1000 | 0.08704 | $435.20 | $87.04
MCT06030C2352FP500 | MCT06030C2352FP500-ND | 5000 1000 | 0.01581 | $79.05 | $15.81
CPF0805B48K7E | CPF0805B48K7E-ND | 5000 1000 | 0.10578 | $528.88 | $105.78
CRCW04025K10JNED | 541-5.1KJCT-ND | 2000 | 0.00511 | $10.22 | $10.22
CRCW04029K10JNED | 541-9.1KJCT-ND | 1000 | 0.00511 | $5.11 | $5.11
CRCW040251K0FKED | 541-51.0KLCT-ND | 1000 | 0.00596 | $5.96 | $5.96
CRCW0603510RJNEA | 541-510GCT-ND | 1000 | 0.00511 | $5.11 | $5.11
MCT06030C2352FP500 | MCT06030C2352FP500-ND | 5000 1000 | 0.01581 | $79.05 | $15.81
RCWE0612R200JNEA | 541-2502-1-ND | 1000 | 0.1735 | $173.50 | $173.50
C1608JB2A102K080AA | 445-11305-1-ND | 1000 | 0.0121 | $12.10 | $12.10
C1005X5R0J225K050BC | 445-6847-1-ND | 1000 | 0.04225 | $42.25 | $42.25
12063C204KAT4A | 478-12814-1-ND | 2000 | 0.11453 | $229.06 | $229.06
SBR3U60P5-7 | SBR3U60P5-7DICT-ND | 1000 | 0.24278 | $242.78 | $242.78
293D155X9050C2TE3 | 718-1811-2-ND | 1000 | 0.34291 | $342.91 | $342.91
ES3B | ES3BFSCT-ND | 1000 | 0.1428 | $142.80 | $142.80
1715721 | 277-1263-ND | 1000 | 0.9435 | $943.50 | $943.50
1729131 | 277-1248-ND | 1000 | 1.173 | $1173.00 | $1173.00
PCB |  |  |  | $1013.00 | $1013.00
Total from digikey |  |  |  | $15013.58 | $14115.84
From mouser 1000 pieces prices |  |  |  | 1984.00 € | $1984.00
Total |  |  |  | $17414.22 | $15128.84
Per unit price |  |  |  | $17.41 | $15.13
For PCB there is $273 shipping cost which is inserted in the analysis.
