mehmetkl/AC-DC-Battery-Charger-Project/Controller/TL594 Components/49kResistanceCADmodelExist.png

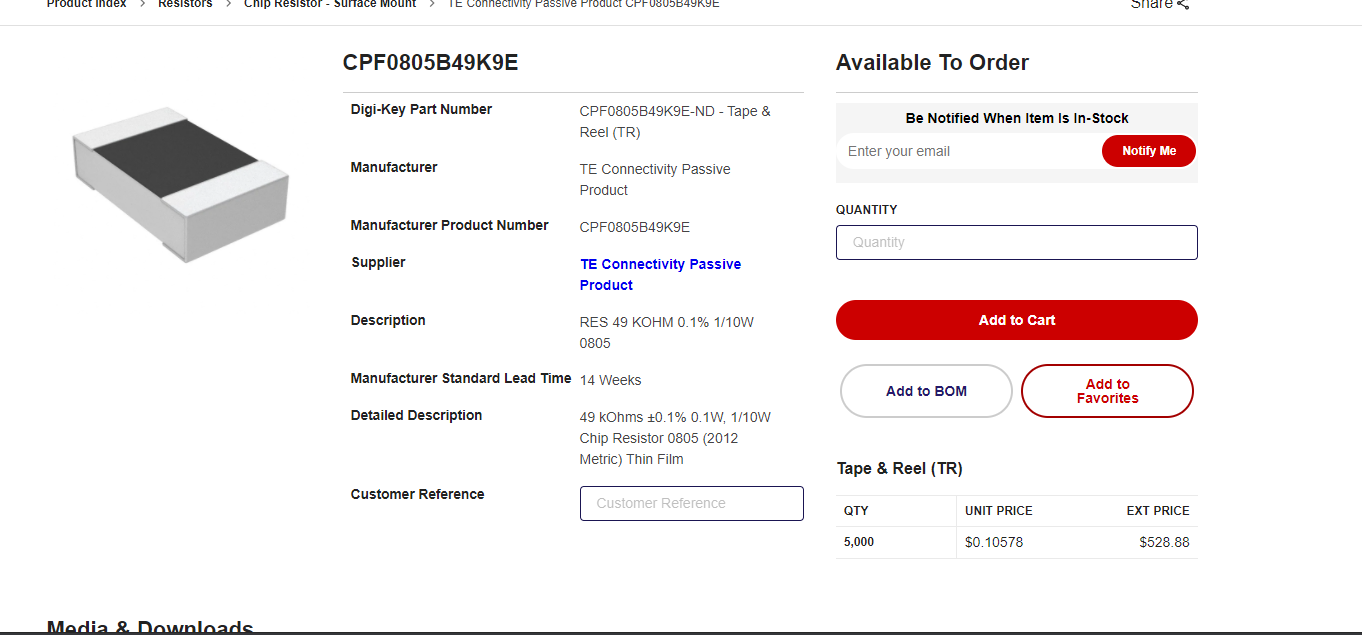
Controller/TL594 Components/49kResistanceCADmodelExist.png
