mehmetkl/AC-DC-Battery-Charger-Project/PCB Cost.png

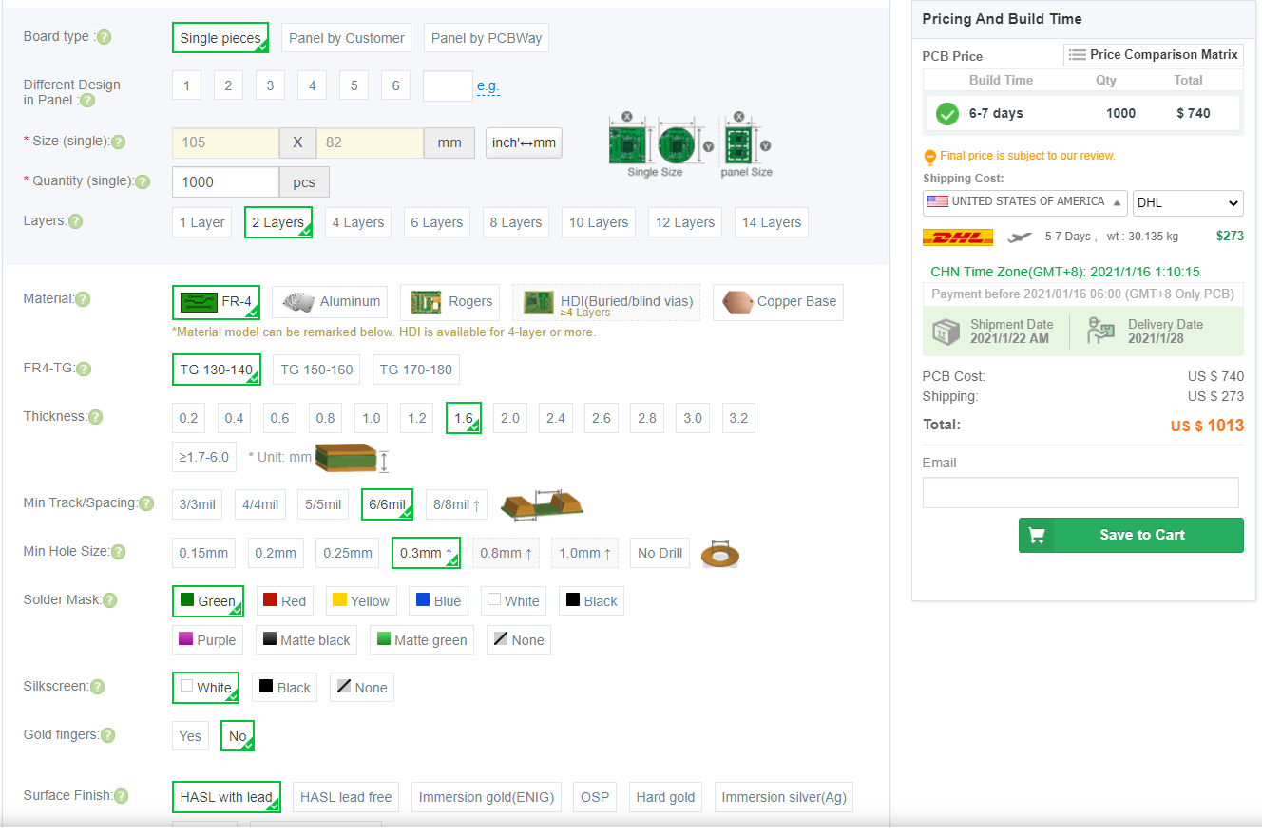
PCB Cost.png
