mehmetkl/AC-DC-Battery-Charger-Project/Buck_converter/components/User Library-TO252AA (2)/User Library-TO252AA.STEP

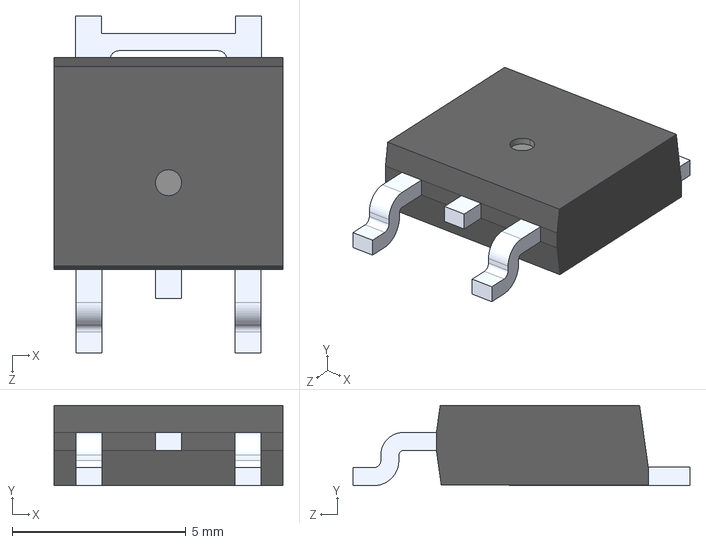
[picture p138: CAD file, 2020-12-25]
Buck_converter/components/User Library-TO252AA (2)/User Library-TO252AA.STEP
6.58 x 2.31 x 9.70 mm
