mehmetkl/AC-DC-Battery-Charger-Project/Final simulations + model/final plots/switching characteristics.jpg

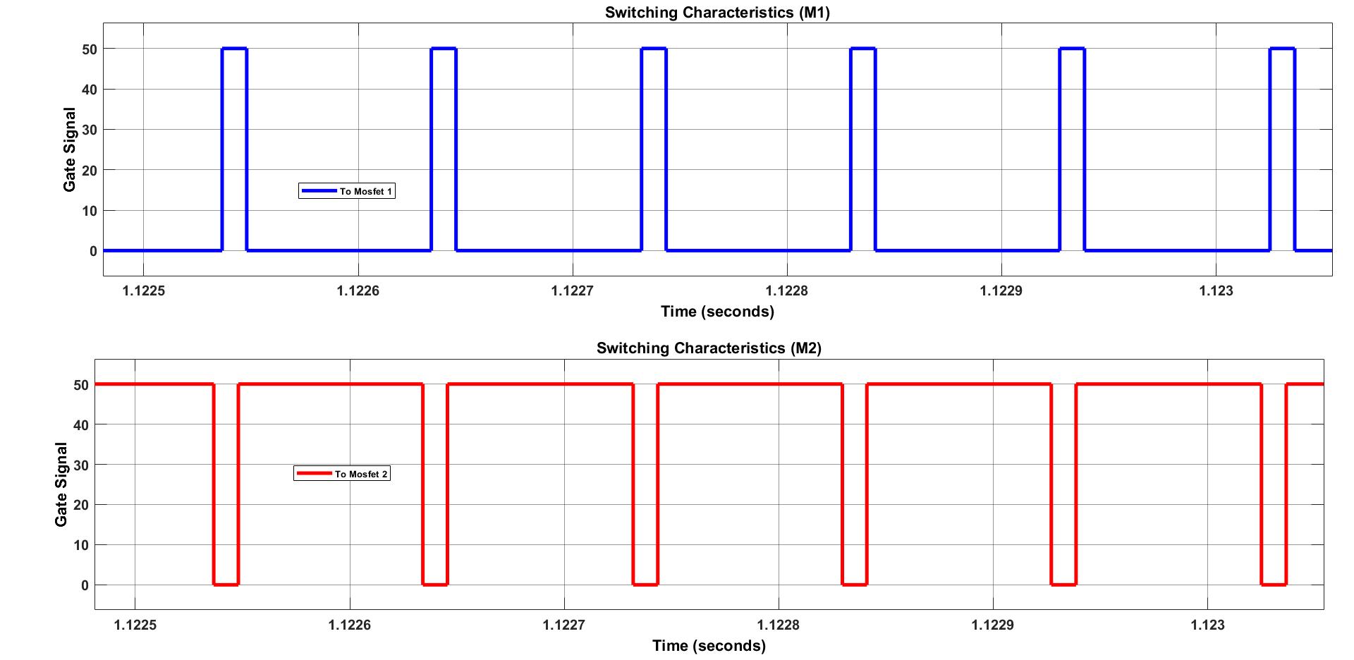
Final simulations + model/final plots/switching characteristics.jpg
