mehmetkl/AC-DC-Battery-Charger-Project/Final simulations + model/rectifier measurements.jpg

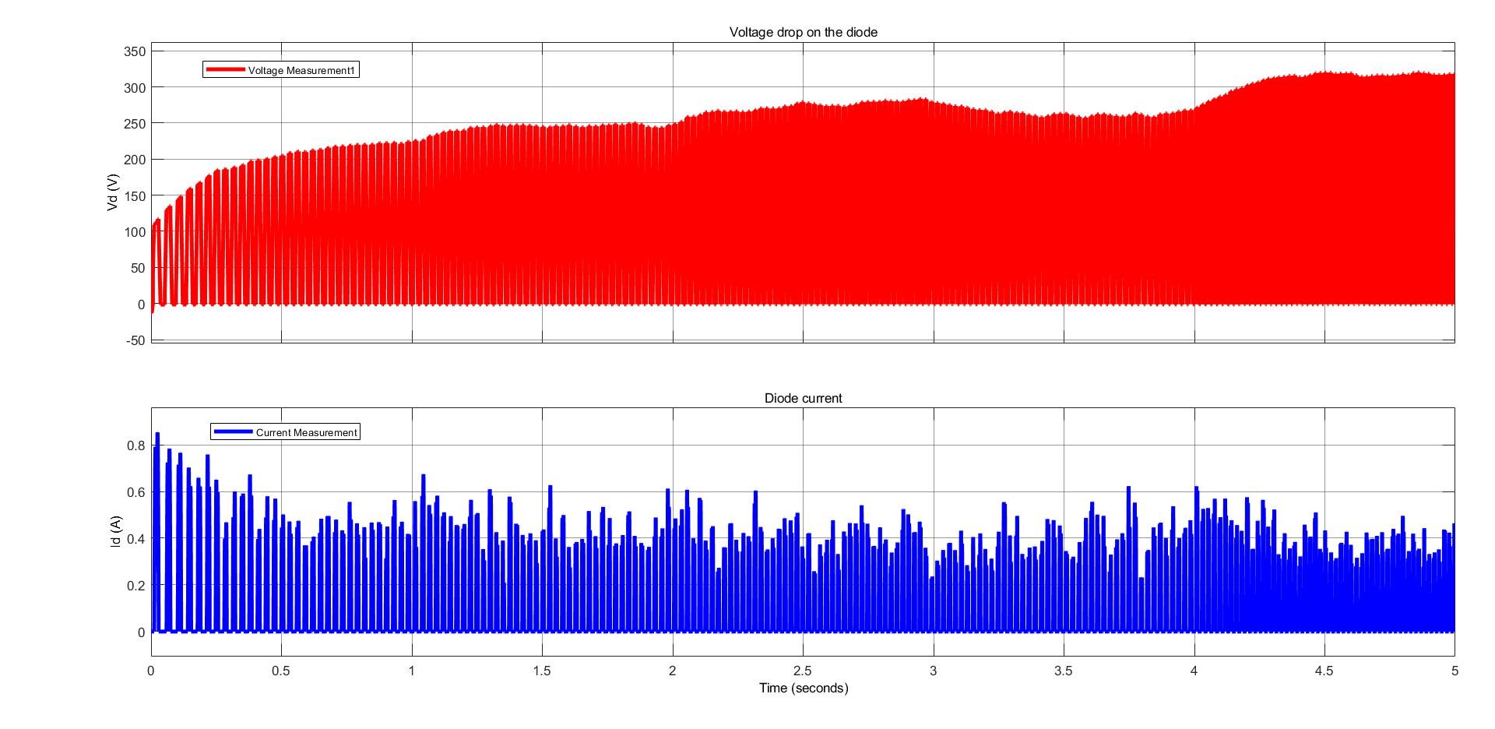
Final simulations + model/rectifier measurements.jpg
