mehmetkl/AC-DC-Battery-Charger-Project/PCB/Three_phase_buck_converter_battery_charger/PCB1.pdf

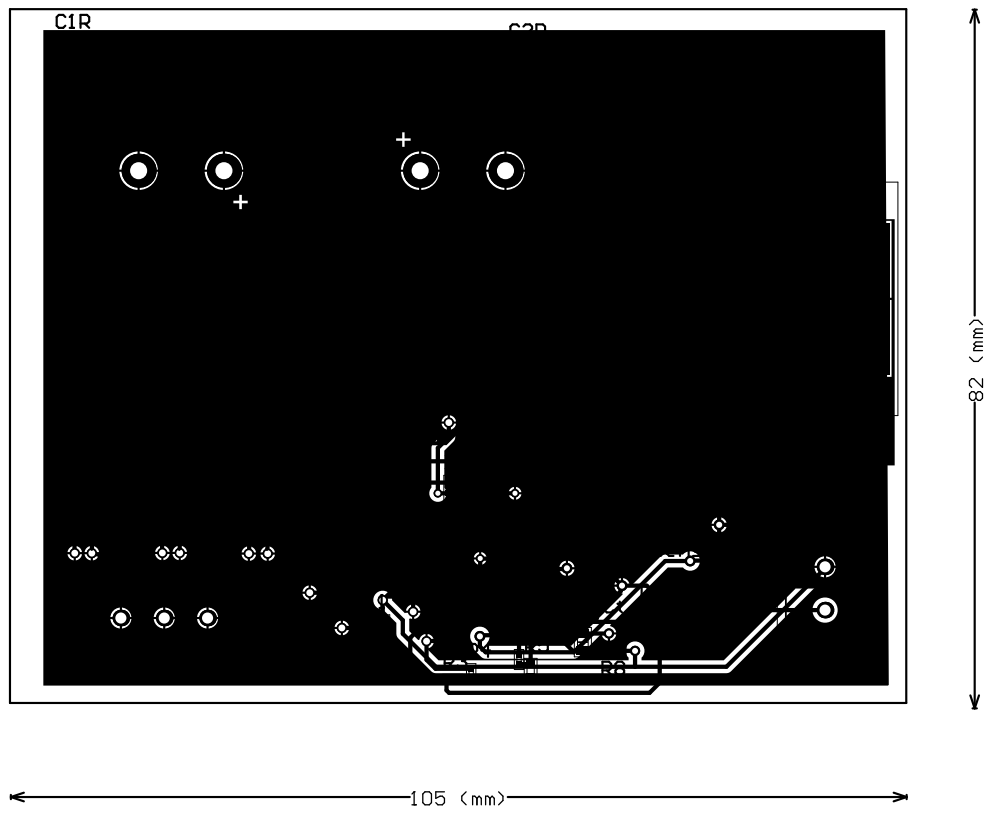
[picture p141: page 1]
