mehmetkl/AC-DC-Battery-Charger-Project/PCB/Three_phase_buck_converter_battery_charger/Three_phase_buck_converter_battery_charger.pdf

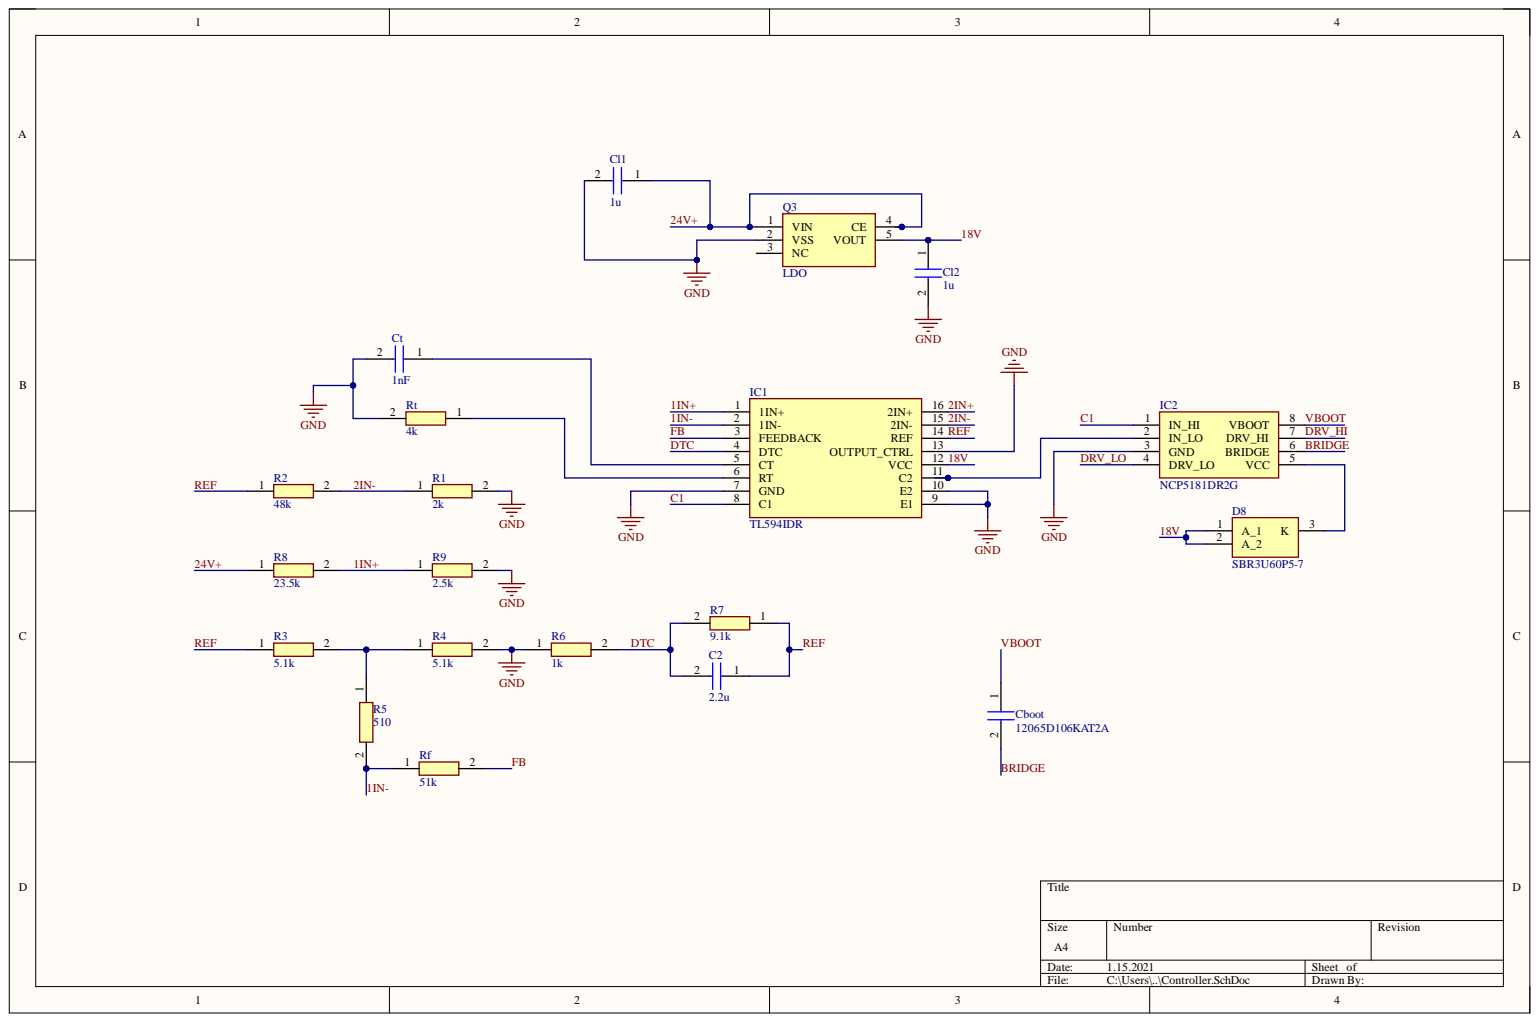
[picture p142: page 1]

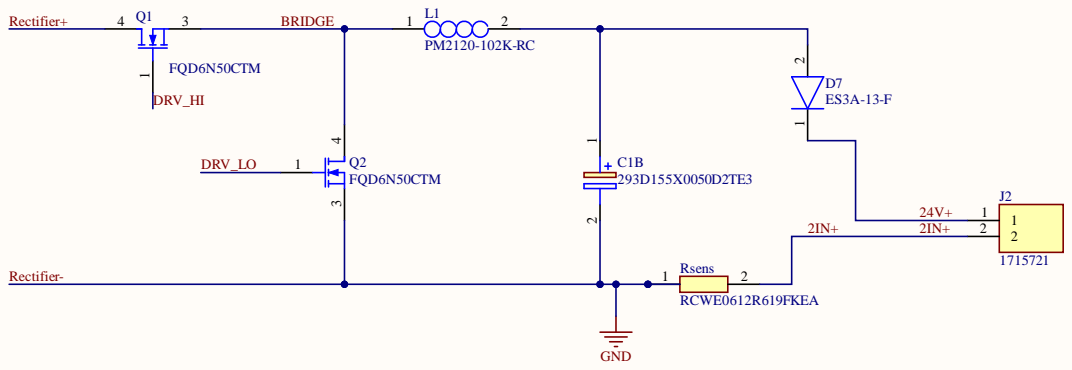
[picture p143: page 2]

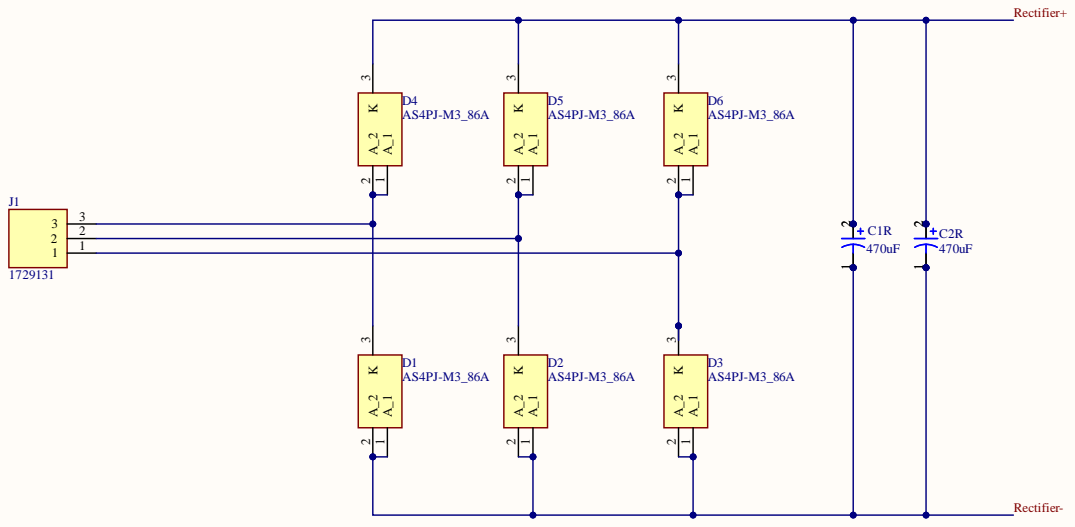
[picture p144: page 3]

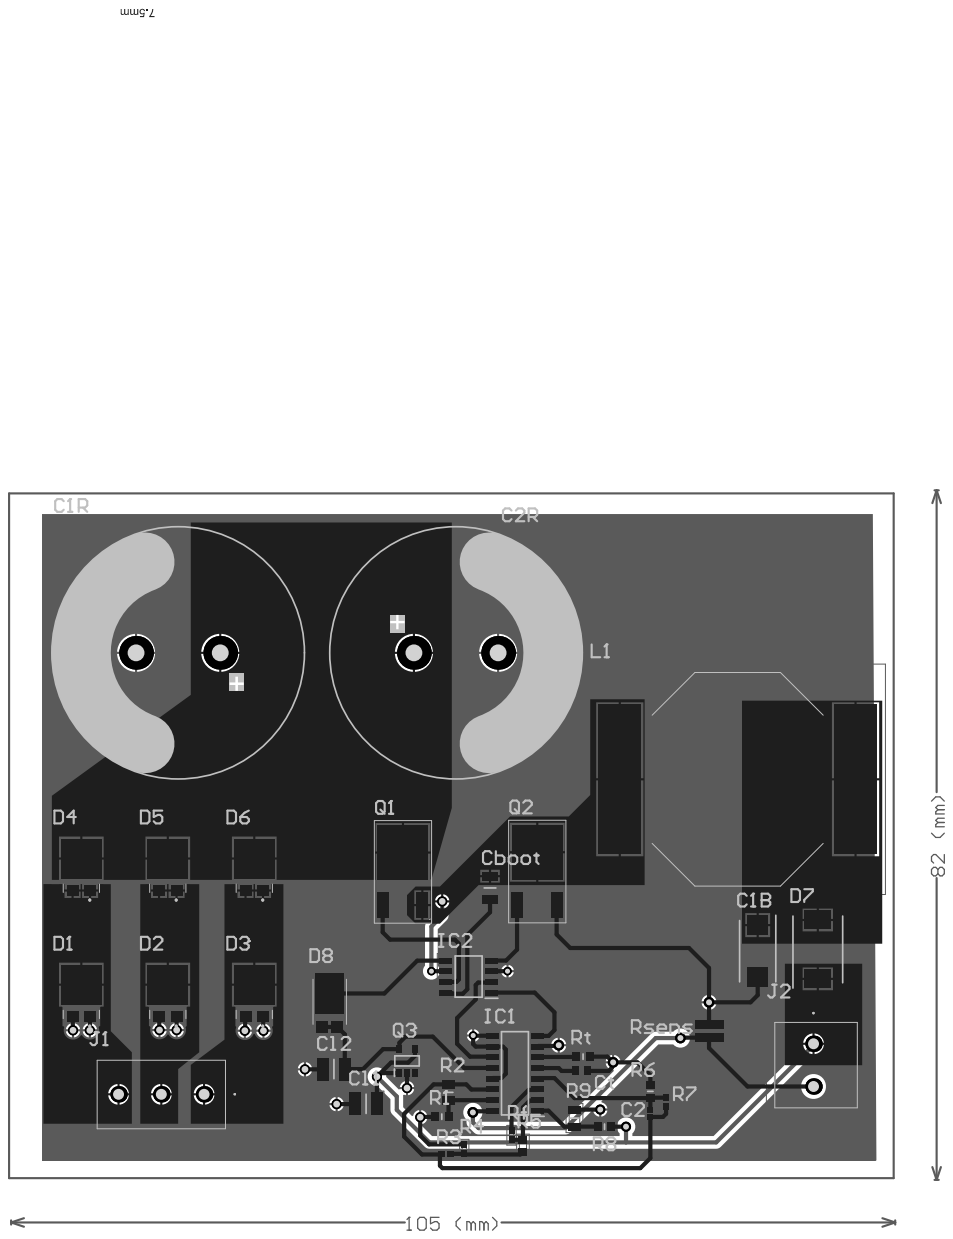
[picture p145: page 4]
