mehmetkl/AC-DC-Battery-Charger-Project/(list of files, drawings)

Other design files:
Buck_converter/components/User Library-TO252AA (2)/Controller.SchDoc
Buck_converter/components/User Library-TO252AA (2)/Converter.SchDoc
PCB/Three_phase_buck_converter_battery_charger/Controller.SchDoc
PCB/Three_phase_buck_converter_battery_charger/Converter.SchDoc
PCB/Three_phase_buck_converter_battery_charger/PCB1.PcbDoc
PCB/Three_phase_buck_converter_battery_charger/PcbLib1.PcbLib
PCB/Three_phase_buck_converter_battery_charger/Rectifier.SchDoc
PCB/Three_phase_buck_converter_battery_charger/Schlib1.SchLib
PCB/Three_phase_buck_converter_battery_charger/Three_phase_buck_converter_battery_charger.PrjPcb
