mehmetkl/AC-DC-Battery-Charger-Project/(commit log)

2020-12-04 A nice example of inductor design for buck conv.
2020-12-04 Add files via upload
    Diode rectifier design is completed for the draft version.
2020-12-24 The simulation part is complited, only one of the diodes is missing which is collected to the battery.
2020-12-24 The driver has been chosen however the pwm gnerator of the circuit is missing.
2020-12-25 Add files via upload
    Controller is updated in order to put the output current in a 20% ripple range.
2020-12-25 Add files via upload
    Battery current waveform is uploaded
2020-12-25 Output diode selection
    https://componentsearchengine.com/part-view/MBRD340T4G/ON%20Semiconductor
2020-12-25 Buck output diode
    Output diode selected.
2020-12-25 Buck converter output inductance is updated
    https://eu.mouser.com/ProductDetail/JW-Miller/PM2120-102K-RC/?qs=nU%2Fbzs1PWpjAOg4vTB9Qkw%3D%3D
2020-12-25 Add files via upload
    Mosfet 1 voltage plot is uploaded
2020-12-25 PCB outcomes for report
2021-01-12 Create VoltageRegulator.pdf
    Voltage Regulator for controller and driver
2021-01-12 Create VoltageRegulatorCapacitance.pdf
    Regulator capacitor
2021-01-15 MOUSER BOM
2021-01-15 Shopping Chart Digikey
    The BOM is waited from the Digikey registration status
2021-01-15 Create Heatsink- Board-Level-Cooling-Surface-Mount-5734.pdf
2021-01-15 Bill of Materials
    [Bill of Materials Arrangable.xlsx]
